sachinthaLUT/RIGOR/photos/README.md

# Photos

Photographs of the built rig (CC BY 4.0). Resized to 2000 px; camera metadata removed.

| File | Shows |
|---|---|
| [`rig_overview.jpg`](rig_overview.jpg) | Complete rig: control enclosure, actuator, load cell and reaction plate on the T-slot frame |
| [`enclosure.jpg`](enclosure.jpg) | Control enclosure with touchscreen, emergency stop and cable glands |
| [`enclosure_lid.jpg`](enclosure_lid.jpg) | Enclosure lid, outside |
| [`enclosure_lid_inside.jpg`](enclosure_lid_inside.jpg) | Enclosure lid, inside: touchscreen module and e-stop wiring |
| [`enclosure_open.jpg`](enclosure_open.jpg) | Enclosure body with the controller PCB fitted |
| [`pcb_v2.1.jpg`](pcb_v2.1.jpg) | Controller PCB V2.1, populated (silkscreen "V2.1 240926") |
