sachinthaLUT/RIGOR/hardware/electronics/datasheets/README.md

# Datasheets

Vendor documents for the main parts, included for convenience. They belong to
their manufacturers and are **not** covered by this repository's licences.
The official sources are linked so you can check for newer versions.

| File | Part | Official source |
|---|---|---|
| `Load cell datasheet.pdf` | ATO-LCC-DYMH-103 load cell | https://www.ato.com/tension-and-compression-load-cell-1kg-to-200kg |
| `OK648 actuator.pdf` | VEVOR OK648 linear actuator | https://eur.vevor.com/linear-actuator-c_44437/vevor-linear-actuator-12v-4-inch-high-load-330lbs-1500n-0-19-s-ip54-protection-p_010907137841 |
| `Motor Driver.pdf` | Pololu G2 High-Power Motor Driver 18v25 (#2994) | https://www.pololu.com/product/2994 |
| `Olimex ADS1220 Breakout Schematic.pdf` | Olimex BB-ADS1220 | https://www.olimex.com/Products/Breadboarding/BB-ADS1220/ |
| `Power supply.pdf` | Mean Well GST160A12-R7B | https://www.meanwell.com/ |
| `Power connector.pdf` | Kycon KPJX-PM-4S panel jack | https://www.kycon.com/ |
| `5.0inch_ESP32-8048S050/` | Sunton ESP32-8048S050 touchscreen: specification, schematics, dimensions, user manual, ESP32-S3 datasheets | https://wiki.makerfabs.com/Sunton_ESP32_S3_5_7_inch_IPS_with_Touch.html |

Other key parts:

| Part | Official source |
|---|---|
| TI ADS1220 (ADC on the Olimex board) | https://www.ti.com/product/ADS1220 |
| Allegro ACS773 current sensor | https://www.allegromicro.com/en/products/sense/current-sensor-ics/fifty-to-two-hundred-amp-integrated-conductor-sensor-ics/acs773 |
| Arduino Nano ESP32 | https://docs.arduino.cc/hardware/nano-esp32/ |
| IDEC AB6E-3BV02PRM emergency stop | https://www.idec.com/ |
