sachinthaLUT/RIGOR/hardware/electronics/gerbers/README.md

# Gerbers

| File | Revision | Status |
|---|---|---|
| `RIGOR_PCB_V2.1_gerbers.zip` | V2.1 (silkscreen `V2.1 240926`, generated 24 Sep 2026) | **Built and characterised in the paper.** Order this to reproduce the published rig. |
| `RIGOR_PCB_V2.2_gerbers.zip` | V2.2 (silkscreen `V2.2 151026`, generated 6 Nov 2026) | Matches the current KiCad project. Touchscreen UART connector J2 re-pinned. Not yet fabricated or tested. |

Both are two-layer boards exported from KiCad 10 (copper, mask, paste,
silkscreen, edge cuts, plated and non-plated drill). Upload the zip as-is to
the PCB fab; the boards were made by JLCPCB with default settings.
