sachinthaLUT/RIGOR/hardware/electronics/kicad/Force_Rig_PCB_V2/PCB Current calculations.xlsx

 | Amps | Volts | Power (W)
Power supply | 11.5 | 12 | 138
 | Rated Amps | Volts | Max Current (Estimated)
Actuator | 5 | 12 | 20
Vevor OK648-1500N
 | Trace width (mils) | Cu Oz
PCB | 486.6206678 | 1
 | K (outer layer) | Delta T | Thickness (mils)
1 Oz Cu | 0.048 | 20 | 1.37
 |  | Max temp diff allowed in C
1 mil = 39.3701mm
Trace width (mm) | 12.36015829 | 13mm
 | Trace width (mils) | Cu Oz
PCB | 243.3103339 | 1
 | K (outer layer) | Delta T | Thickness (mils)
2 Oz Cu | 0.048 | 20 | 2.74
 |  | Max temp diff allowed in C
1 mil = 39.3701mm
Trace width (mm) | 6.180079143 | 7mm
