sachinthaLUT/RIGOR/firmware/hmi/TouchScreenESP32Firmware/mockups/02_Home.png

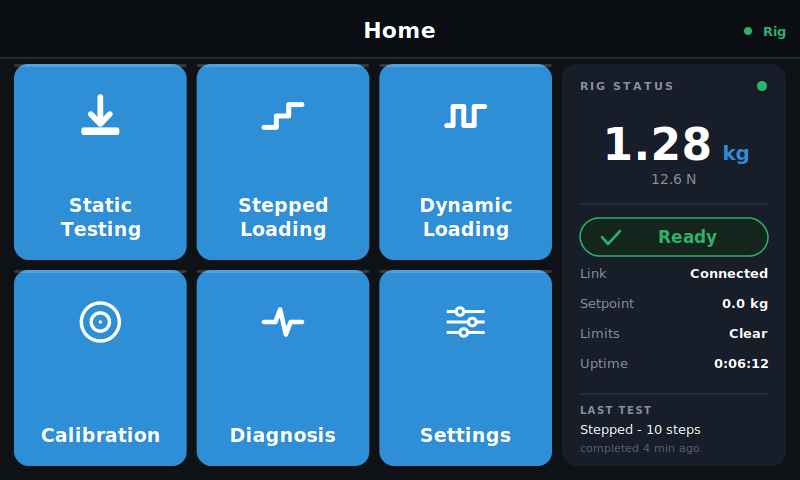
firmware/hmi/TouchScreenESP32Firmware/mockups/02_Home.png
