sachinthaLUT/RIGOR/firmware/hmi/TouchScreenESP32Firmware/mockups/03b_Static_Custom_Keypad.png

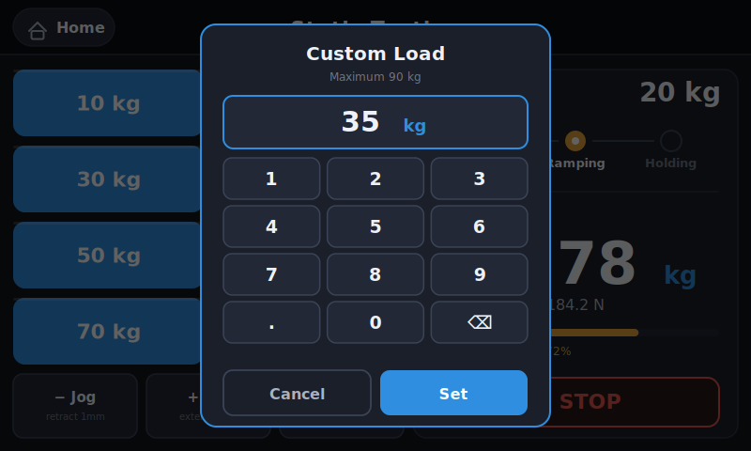
firmware/hmi/TouchScreenESP32Firmware/mockups/03b_Static_Custom_Keypad.png
