sachinthaLUT/RIGOR/firmware/hmi/TouchScreenESP32Firmware/mockups/04_Stepped_Loading.png

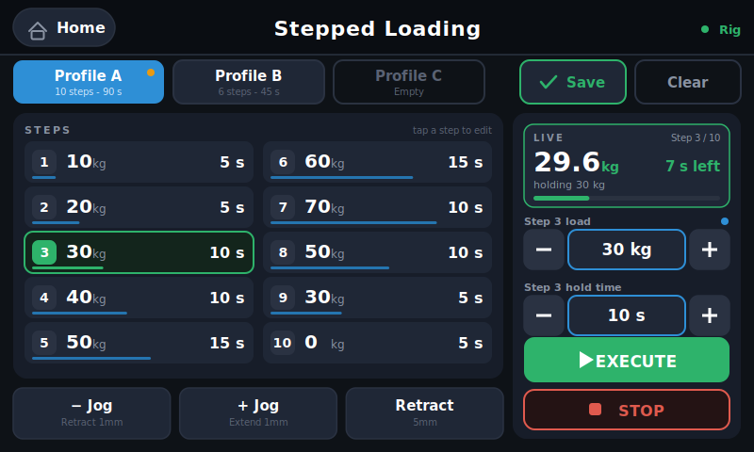
firmware/hmi/TouchScreenESP32Firmware/mockups/04_Stepped_Loading.png
