sachinthaLUT/RIGOR/firmware/hmi/TouchScreenESP32Firmware/mockups/05_Dynamic_Loading.png

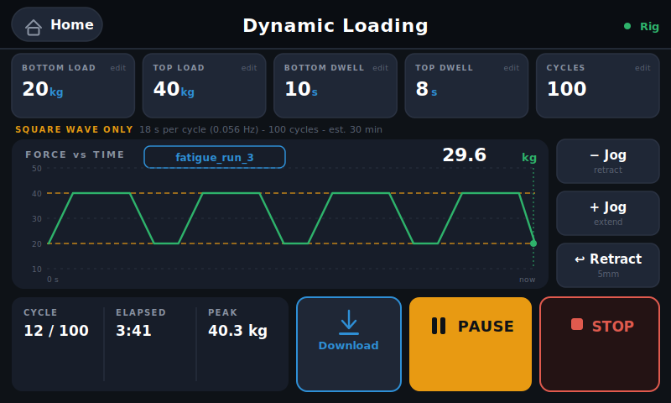
firmware/hmi/TouchScreenESP32Firmware/mockups/05_Dynamic_Loading.png
