sachinthaLUT/RIGOR/firmware/hmi/TouchScreenESP32Firmware/mockups/05b_Dynamic_Download.png

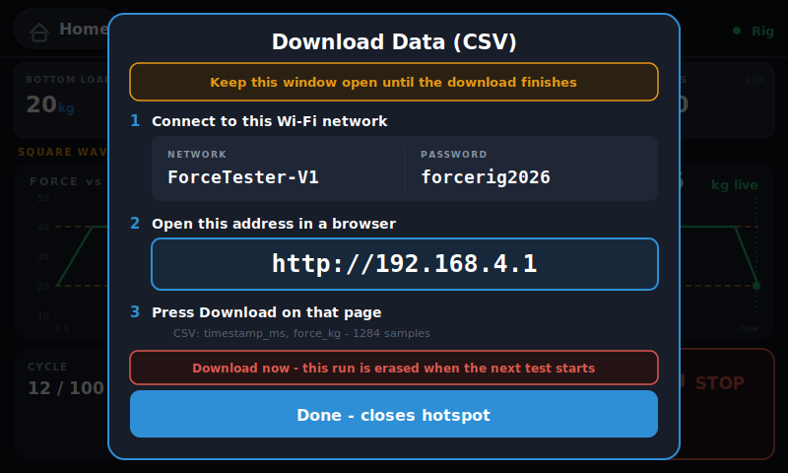
firmware/hmi/TouchScreenESP32Firmware/mockups/05b_Dynamic_Download.png
