sachinthaLUT/RIGOR/firmware/hmi/TouchScreenESP32Firmware/mockups/06_Diagnosis.png

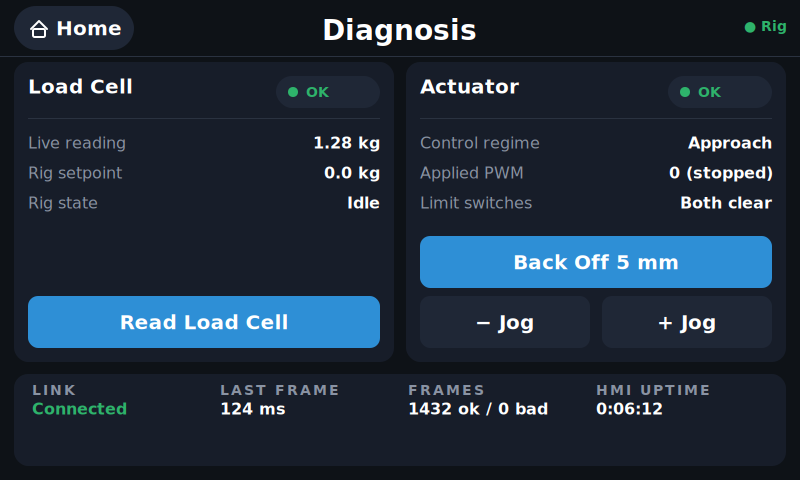
firmware/hmi/TouchScreenESP32Firmware/mockups/06_Diagnosis.png
