sachinthaLUT/RIGOR/firmware/hmi/TouchScreenESP32Firmware/mockups/06_WebPage.png

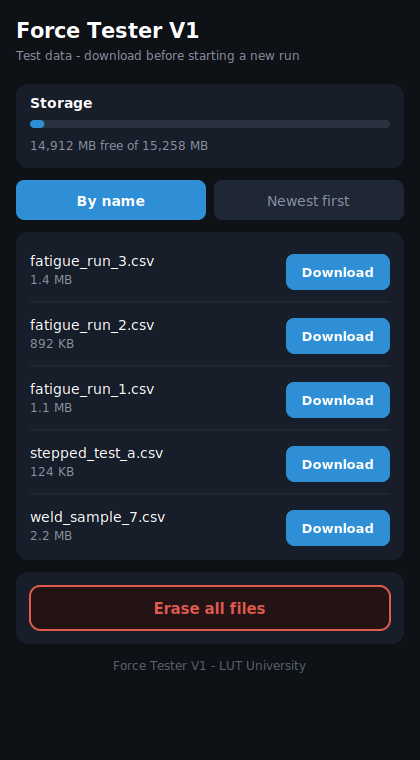
firmware/hmi/TouchScreenESP32Firmware/mockups/06_WebPage.png
