sachinthaLUT/RIGOR/firmware/hmi/TouchScreenESP32Firmware/mockups/07_Settings.png

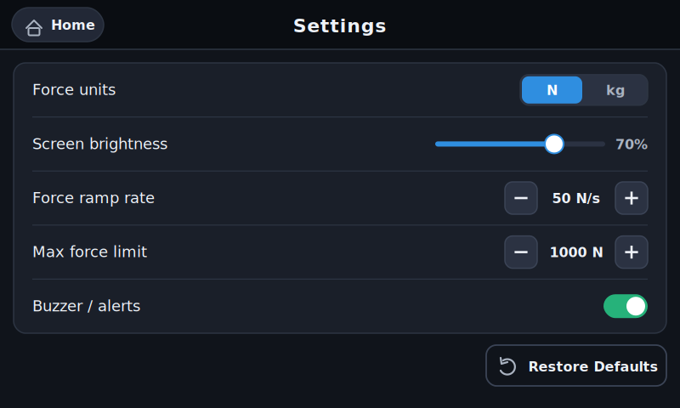
firmware/hmi/TouchScreenESP32Firmware/mockups/07_Settings.png
