sachinthaLUT/RIGOR/firmware/hmi/TouchScreenESP32Firmware/mockups/08_About.png

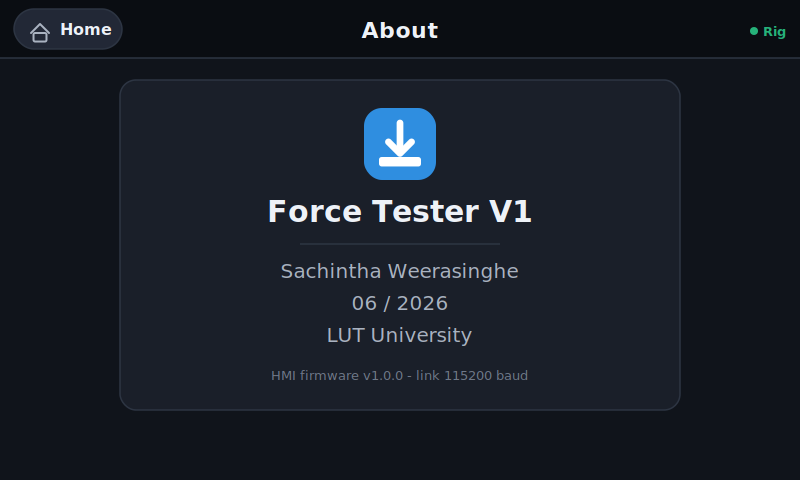
firmware/hmi/TouchScreenESP32Firmware/mockups/08_About.png
