sachinthaLUT/RIGOR/hardware/electronics/kicad/Force_Rig_PCB_V2/Back image.png

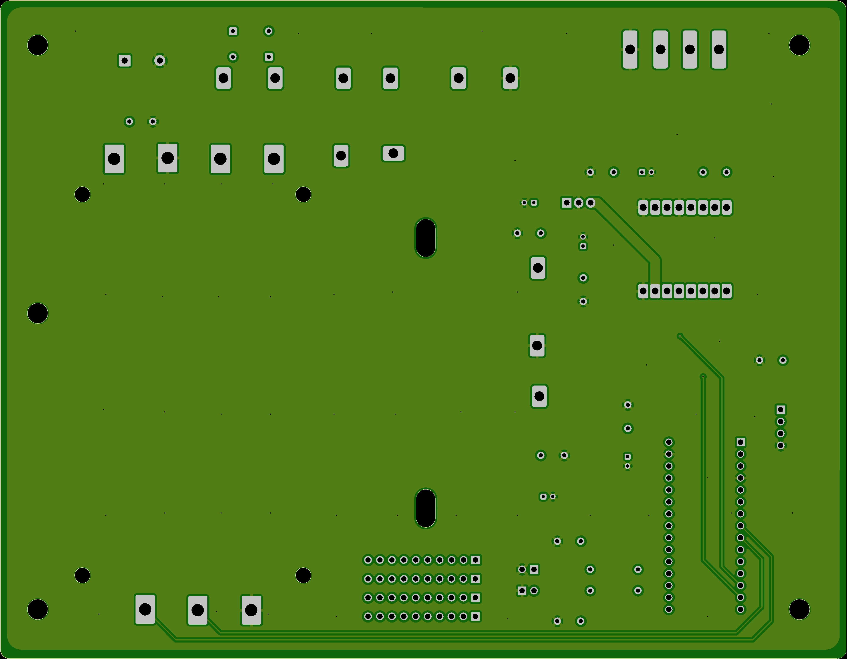
hardware/electronics/kicad/Force_Rig_PCB_V2/Back image.png
