sachinthaLUT/RIGOR/hardware/electronics/kicad/Force_Rig_PCB_V2/Front image.png

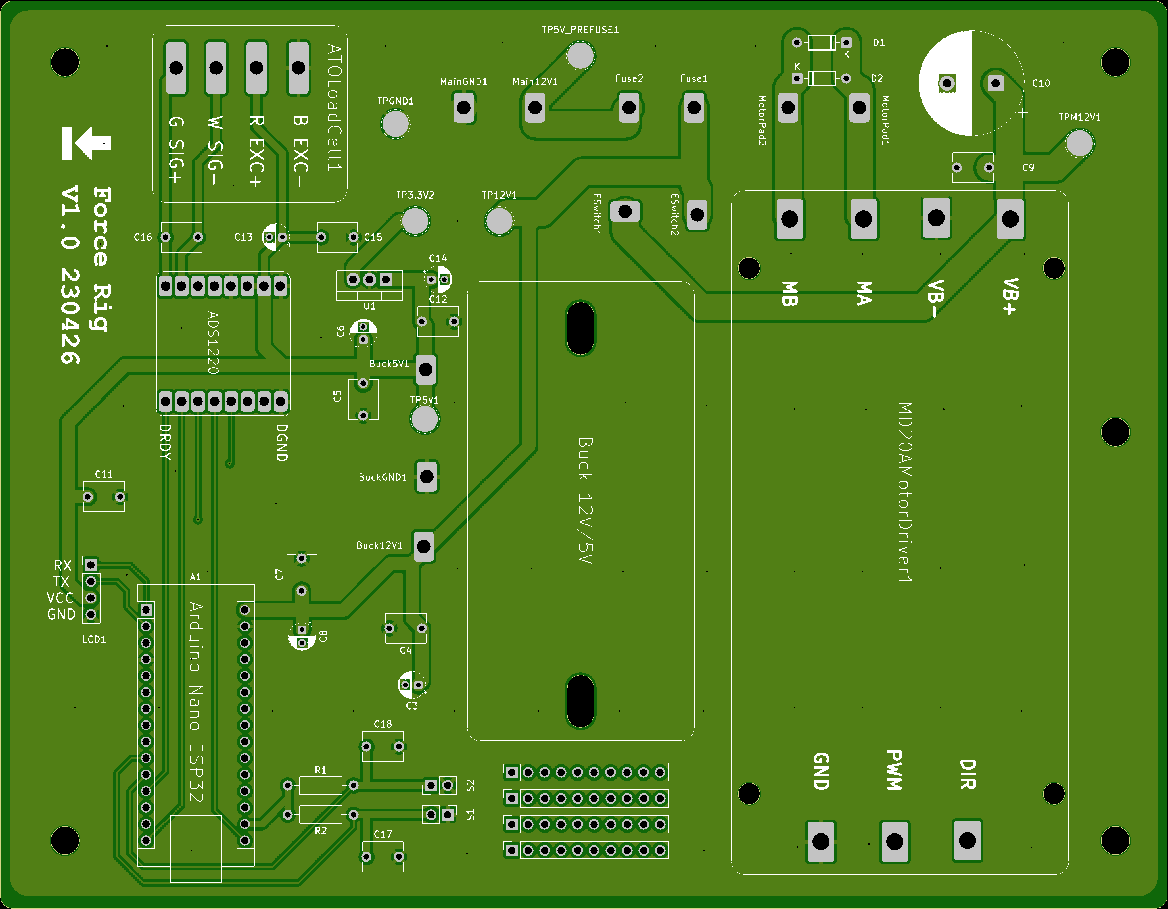
hardware/electronics/kicad/Force_Rig_PCB_V2/Front image.png
