sachinthaLUT/RIGOR/hardware/electronics/kicad/Force_Rig_PCB_V2/Graphics/PCB Isometric.png

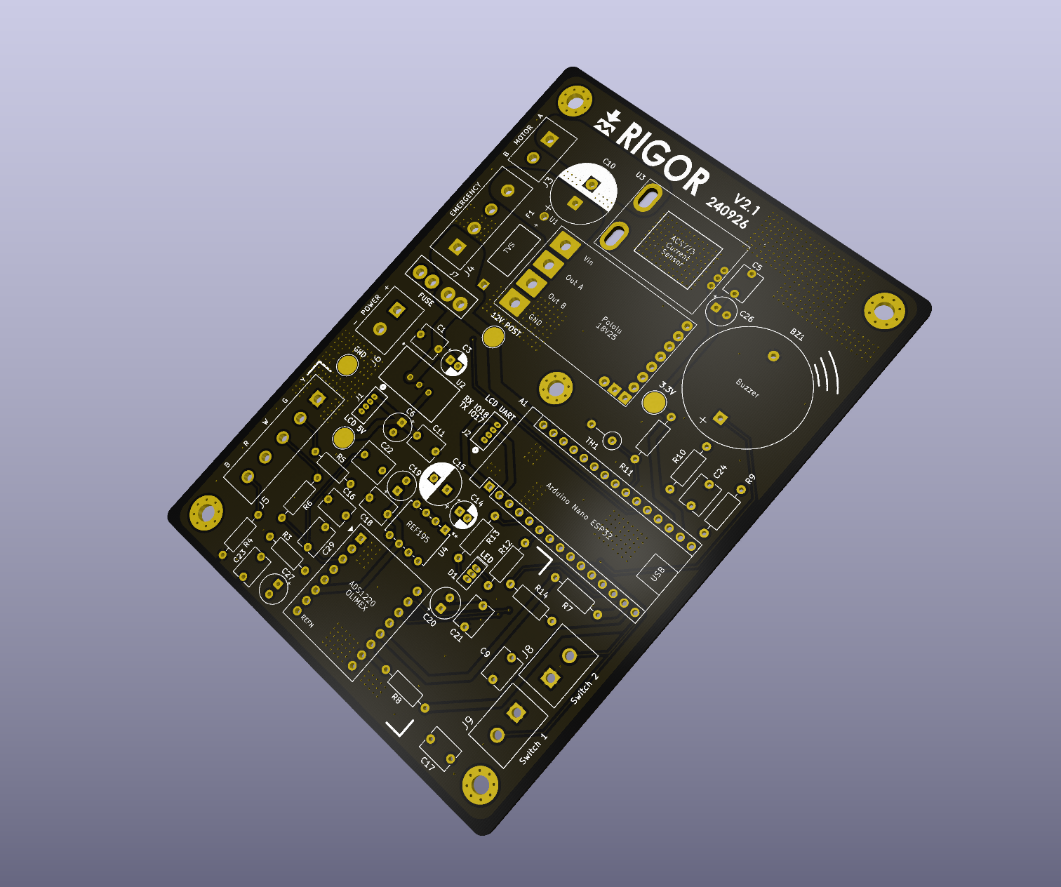
hardware/electronics/kicad/Force_Rig_PCB_V2/Graphics/PCB Isometric.png
