sachinthaLUT/RIGOR/photos/enclosure_lid.jpg

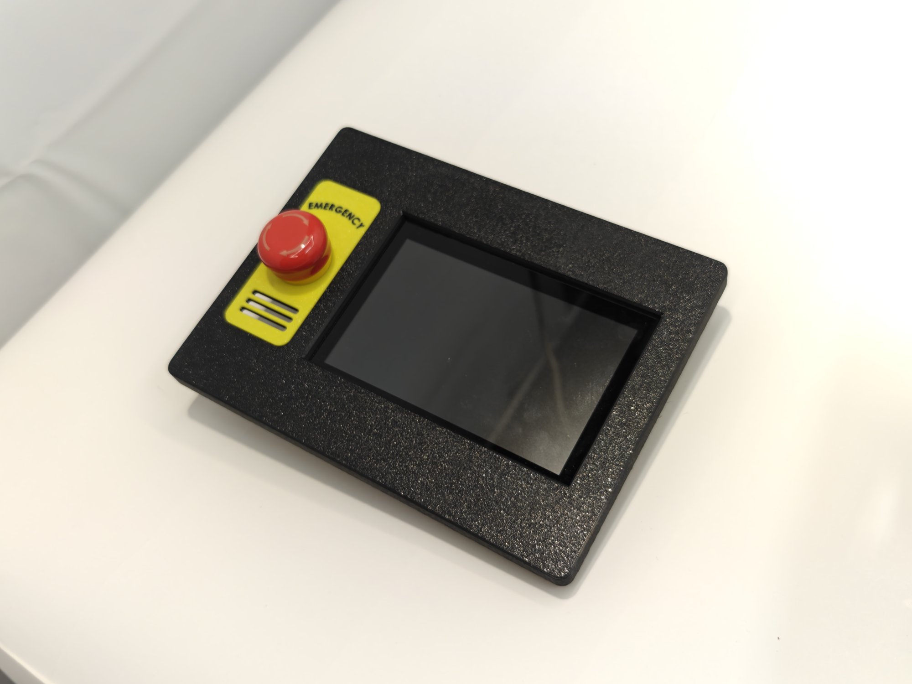
photos/enclosure_lid.jpg
