sachinthaLUT/RIGOR/photos/enclosure_lid_inside.jpg

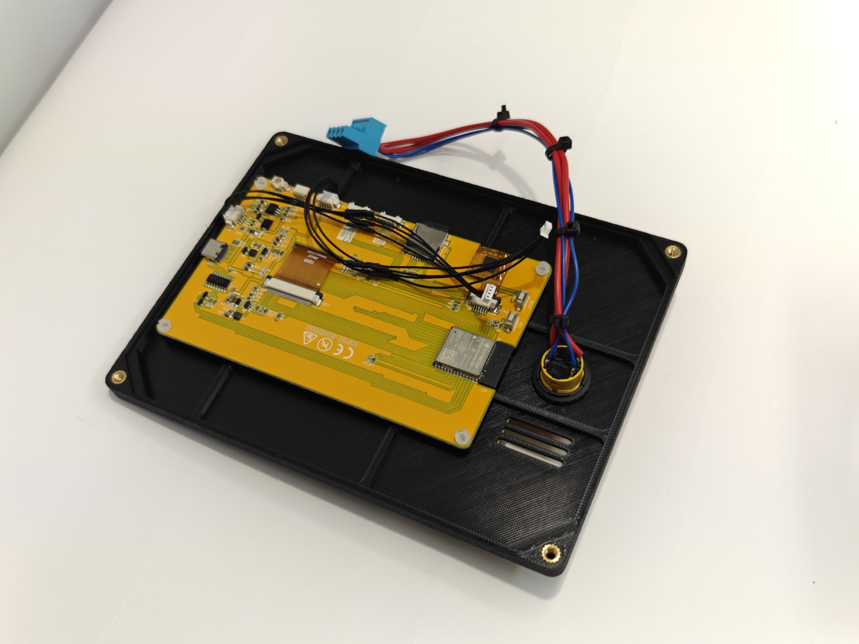
photos/enclosure_lid_inside.jpg
