sachinthaLUT/RIGOR/hardware/bom/BOM.csv

Item | Section | Table 3 category | Component | Function / where used | Manufacturer | Manufacturer part no. / specification | Supplier | Supplier part no. | Qty | Unit price (€) | Line total (€) | Product URL | Datasheet URL | Notes | Price source
A. Actuation and sensing
A1 | A | Linear actuator | Linear actuator | Prime mover; self-locking leadscrew, built-in limit switches | VEVOR | 12 V, 4 in (100 mm) stroke, 1500 N (330 lb), 0.19 in/s (≈5 mm/s), IP54 | VEVOR EU | 010907137841 | 1 | 30 | 30 | https://eur.vevor.com/linear-actuator-c_44437/vevor-linear-actuator-12v-4-inch-high-load-330lbs-1500n-0-19-s-ip54-protection-p_010907137841 |  | 25 % duty cycle | User (as purchased)
A2 | A | Load cell | Load cell, 100 kg | In-line force measurement, tension/compression, M6 both ends | ATO | ATO-LCC-DYMH-103 | ATO | ATO-LCC-DYMH-103 (100 kg) | 1 | 125 | 125 | https://www.ato.com/tension-and-compression-load-cell-1kg-to-200kg |  | Product page covers 1–200 kg; order the 100 kg variant | User (as purchased)
B. Controller PCB V2.1: board, modules and ICs
B1 | B | Controller PCB V2.1 | Bare PCB V2.1 | Controller board (KiCad files in repository) | JLCPCB | RIGOR controller PCB V2.1 | JLCPCB | — | 1 | 40 | 40 | https://jlcpcb.com |  | Cost of the minimum-order batch, excluding shipping; spare boards included | User (JLCPCB order)
B2 | B | Controller PCB V2.1 | Microcontroller, Arduino Nano ESP32 | 50 Hz force loop, safety supervision, UART to touchscreen | Arduino | ABX00083 | Digi-Key | 1050-ABX00083-ND | 1 | 17.13 | 17.13 | https://www.digikey.fi/en/products/result?keywords=1050-ABX00083-ND | https://mm.digikey.com/Volume0/opasdata/d220001/medias/docus/9031/ABX00083.pdf |  | Digi-Key order (user export)
B3 | B | Controller PCB V2.1 | ADC breakout, Olimex BB-ADS1220 | 24-bit ΔΣ load-cell ADC, PGA ×128, ratiometric | Olimex LTD | BB-ADS1220 | Digi-Key | 1188-BB-ADS1220-ND | 1 | 16.29 | 16.29 | https://www.digikey.fi/en/products/result?keywords=1188-BB-ADS1220-ND | https://www.olimex.com/Products/Breadboarding/BB-ADS1220/resources/ads1220.pdf |  | Digi-Key order (user export)
B4 | B | Motor driver | Motor driver, Pololu G2 High-Power 18v25 | Actuator H-bridge, PWM + DIR at 20 kHz, fault output | Pololu | 2994 | Digi-Key | 2183-2994-ND | 1 | 50.55 | 50.55 | https://www.digikey.fi/en/products/result?keywords=2183-2994-ND | https://www.pololu.com/product-info-merged/2994 |  | Digi-Key order (user export)
B5 | B | Controller PCB V2.1 | Current sensor ACS773 (±50 A) | Hall-effect motor-current sensing, in series with the motor | Allegro MicroSystems | ACS773LCB-050B-PFF-T | Digi-Key | ACS773LCB-050B-PFF-T-ND | 1 | 8.94 | 8.94 | https://www.digikey.fi/en/products/result?keywords=ACS773LCB-050B-PFF-T-ND | https://www.allegromicro.com/~/media/Files/Datasheets/ACS773-Datasheet.ashx |  | Digi-Key order (user export)
B6 | B | Controller PCB V2.1 | DC-DC converter 5 V, 10 W (Traco TSR 2-2450) | 12 V → 5 V logic supply | Traco Power | TSR 2-2450 | Digi-Key | 1951-2692-ND | 1 | 11.75 | 11.75 | https://www.digikey.fi/en/products/result?keywords=1951-2692-ND | https://www.tracopower.com/products/tsr2.pdf |  | Digi-Key order (user export)
B7 | B | Controller PCB V2.1 | Voltage reference 5 V (REF195) | Precision 5 V reference | Analog Devices Inc. | REF195GPZ | Digi-Key | REF195GPZ-ND | 1 | 7.72 | 7.72 | https://www.digikey.fi/en/products/result?keywords=REF195GPZ-ND | https://www.analog.com/media/en/technical-documentation/data-sheets/REF19XSERIES.pdf |  | Digi-Key order (user export)
B8 | B | Controller PCB V2.1 | NTC thermistor 10 kΩ, B 3950 | Motor-driver temperature (over-temperature protection) | Vishay Ametherm | PANE103395 | Digi-Key | 570-PANE103395-ND | 1 | 2.35 | 2.35 | https://www.digikey.fi/en/products/result?keywords=570-PANE103395-ND | https://www.ametherm.com/datasheetspdf/PANE103395.pdf | Bonded to the driver with thermal epoxy (section G) | Digi-Key order (user export)
B9 | B | Controller PCB V2.1 | Piezo buzzer 23 mm | Audible alarms and confirmations | Mallory Sonalert Products Inc. | MSR205NSR | Digi-Key | 458-1314-ND | 1 | 11.02 | 11.02 | https://www.digikey.fi/en/products/result?keywords=458-1314-ND | https://www.mspindy.com/spec-sheets/MSR205NSR.pdf |  | Digi-Key order (user export)
B10 | B | Controller PCB V2.1 | Bi-colour LED, red/green | Status indicator | Broadcom Limited | HLMP-0800 | Digi-Key | 516-1280-ND | 1 | 1 | 1 | https://www.digikey.fi/en/products/result?keywords=516-1280-ND | https://docs.broadcom.com/docs/AV02-1552EN |  | Digi-Key order (user export)
B11 | B | Controller PCB V2.1 | Fuse holder, blade, PCB mount | Motor-supply fuse holder | Keystone Electronics | 3544-2 | Digi-Key | 36-3544-2-ND | 1 | 0.87 | 0.87 | https://www.digikey.fi/en/products/result?keywords=36-3544-2-ND | https://www.keyelco.com/userAssets/file/K75p48.pdf |  | Digi-Key order (user export)
B12 | B | Controller PCB V2.1 | Fuse 20 A, mini blade | Motor-supply overcurrent protection | Littelfuse Inc. | 0297020.WXNV | Digi-Key | F993-ND | 1 | 0.35 | 0.35 | https://www.digikey.fi/en/products/result?keywords=F993-ND | https://www.littelfuse.com/assetdocs/littelfuse_datasheet_297_mini32v.pdf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 |  | Digi-Key order (user export)
B13 | B | Controller PCB V2.1 | TVS diode 1.5KE20CA (bidirectional) | Transient suppression on the 12 V motor supply | Littelfuse Inc. | 1.5KE20CA | Digi-Key | 1.5KE20CALFCT-ND | 1 | 1.01 | 1.01 | https://www.digikey.fi/en/products/result?keywords=1.5KE20CALFCT-ND | https://www.littelfuse.com/media?itemid=9D02C7D2-86A5-4BFF-9251-966D6AF02BF7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 |  | Digi-Key order (user export)
C. Controller PCB V2.1: passives and connectors
C1 | C | Controller PCB V2.1 | Capacitor 100 nF, 100 V, X7R | Decoupling | Vishay Beyschlag/Draloric/BC Components | K104K15X7RH53H5G | Digi-Key | 56-K104K15X7RH53H5G-ND | 6 | 0.83 | 4.98 | https://www.digikey.fi/en/products/result?keywords=56-K104K15X7RH53H5G-ND | https://www.vishay.com/docs/45250/kgseries.pdf |  | Digi-Key order (user export)
C2 | C | Controller PCB V2.1 | Capacitor 100 nF, 50 V, ceramic (Murata) | Decoupling / filtering | Murata Electronics | RDE5C1H104J2K1H03B | Digi-Key | 490-RDE5C1H104J2K1H03B-ND | 5 | 0.75 | 3.75 | https://www.digikey.fi/en/products/result?keywords=490-RDE5C1H104J2K1H03B-ND | https://pim.murata.com/asset/pim4/ceramicCapacitorLead/RDE_C0G_50V-100V_E_PDF_CERAMICCAPACITORLEAD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 |  | Digi-Key order (user export)
C3 | C | Controller PCB V2.1 | Capacitor 1 µF, 63 V, film | Filtering | KEMET | R82DC4100DQ60J | Digi-Key | 399-5447-1-ND | 1 | 0.59 | 0.59 | https://www.digikey.fi/en/products/result?keywords=399-5447-1-ND | https://yageogroup.com/content/datasheet/asset/file/KEM_F3101_R82 |  | Digi-Key order (user export)
C4 | C | Controller PCB V2.1 | Capacitor 10 µF, 20 V, tantalum | Supply decoupling | KYOCERA AVX | TAP106J020SRN | Digi-Key | 478-TAP106J020SRNCT-ND | 5 | 1.54 | 7.7 | https://www.digikey.fi/en/products/result?keywords=478-TAP106J020SRNCT-ND | http://datasheets.avx.com/tap.pdf |  | Digi-Key order (user export)
C5 | C | Controller PCB V2.1 | Capacitor 10 µF, 50 V, electrolytic | Supply decoupling | Würth Elektronik | 860020672010 | Digi-Key | 732-8856-1-ND | 3 | 0.1 | 0.3 | https://www.digikey.fi/en/products/result?keywords=732-8856-1-ND | https://www.we-online.com/components/products/datasheet/860020672010.pdf |  | Digi-Key order (user export)
C6 | C | Controller PCB V2.1 | Capacitor 100 µF, 50 V, electrolytic | Supply bulk capacitance | Würth Elektronik | 860040674004 | Digi-Key | 732-9187-1-ND | 1 | 0.31 | 0.31 | https://www.digikey.fi/en/products/result?keywords=732-9187-1-ND | https://www.we-online.com/components/products/datasheet/860040674004.pdf |  | Digi-Key order (user export)
C7 | C | Controller PCB V2.1 | Capacitor 1000 µF, 50 V, electrolytic | Motor-supply bulk capacitance | Würth Elektronik | 860010678024 | Digi-Key | 732-8676-1-ND | 1 | 1.27 | 1.27 | https://www.digikey.fi/en/products/result?keywords=732-8676-1-ND | https://www.we-online.com/components/products/datasheet/860010678024.pdf |  | Digi-Key order (user export)
C8 | C | Controller PCB V2.1 | Resistor 10 Ω, 1/4 W |  | YAGEO | CFR-25JT-52-10R | Digi-Key | 13-CFR-25JT-52-10RCT-ND | 3 | 0.09 | 0.27 | https://www.digikey.fi/en/products/result?keywords=13-CFR-25JT-52-10RCT-ND | https://yageogroup.com/content/datasheet/asset/file/YAGEO-CFR_DATASHEET |  | Digi-Key order (user export)
C9 | C | Controller PCB V2.1 | Resistor 33 Ω, 1/4 W |  | Stackpole Electronics Inc | CF14JT33R0 | Digi-Key | CF14JT33R0CT-ND | 4 | 0.09 | 0.36 | https://www.digikey.fi/en/products/result?keywords=CF14JT33R0CT-ND | https://www.seielect.com/catalog/SEI-CF_CFM.pdf |  | Digi-Key order (user export)
C10 | C | Controller PCB V2.1 | Resistor 220 Ω, 1/4 W | LED current limiting | Stackpole Electronics Inc | CF14JT220R | Digi-Key | CF14JT220RCT-ND | 3 | 0.09 | 0.27 | https://www.digikey.fi/en/products/result?keywords=CF14JT220RCT-ND | https://www.seielect.com/catalog/SEI-CF_CFM.pdf |  | Digi-Key order (user export)
C11 | C | Controller PCB V2.1 | Resistor 1 kΩ, 1/4 W | Pull-up / RC filtering | Stackpole Electronics Inc | CF14JT1K00 | Digi-Key | CF14JT1K00CT-ND | 2 | 0.09 | 0.18 | https://www.digikey.fi/en/products/result?keywords=CF14JT1K00CT-ND | https://www.seielect.com/catalog/SEI-CF_CFM.pdf |  | Digi-Key order (user export)
C12 | C | Controller PCB V2.1 | Resistor 10 kΩ, 1/4 W | Thermistor divider / pull-ups | Stackpole Electronics Inc | CF14JT10K0 | Digi-Key | CF14JT10K0CT-ND | 4 | 0.09 | 0.36 | https://www.digikey.fi/en/products/result?keywords=CF14JT10K0CT-ND | https://www.seielect.com/catalog/SEI-CF_CFM.pdf |  | Digi-Key order (user export)
C13 | C | Controller PCB V2.1 | Terminal block header, 2-pos, 5.08 mm | Off-board connections | Same Sky (Formerly CUI Devices) | TBP01R2-508-02BE | Digi-Key | 102-6422-ND | 4 | 0.24 | 0.96 | https://www.digikey.fi/en/products/result?keywords=102-6422-ND | https://www.cuidevices.com/product/resource/tbp01r2-508.pdf |  | Digi-Key order (user export)
C14 | C | Controller PCB V2.1 | Terminal block plug, 2-pos, 5.08 mm | Off-board connections | Same Sky (Formerly CUI Devices) | TBP01P1-508-02BE | Digi-Key | 102-6390-ND | 4 | 0.6 | 2.4 | https://www.digikey.fi/en/products/result?keywords=102-6390-ND | https://www.cuidevices.com/product/resource/tbp01p1-508.pdf |  | Digi-Key order (user export)
C15 | C | Controller PCB V2.1 | Terminal block header, 4-pos, 5.08 mm | Off-board connections | Same Sky (Formerly CUI Devices) | TBP01R2-508-04BE | Digi-Key | 102-6424-ND | 1 | 0.46 | 0.46 | https://www.digikey.fi/en/products/result?keywords=102-6424-ND | https://www.cuidevices.com/product/resource/tbp01r2-508.pdf |  | Digi-Key order (user export)
C16 | C | Controller PCB V2.1 | Terminal block plug, 4-pos, 5.08 mm | Off-board connections | Same Sky (Formerly CUI Devices) | TBP01P1-508-04BE | Digi-Key | 102-6392-ND | 1 | 1.26 | 1.26 | https://www.digikey.fi/en/products/result?keywords=102-6392-ND | https://www.cuidevices.com/product/resource/tbp01p1-508.pdf |  | Digi-Key order (user export)
C17 | C | Controller PCB V2.1 | Terminal block header, 5-pos, 5.08 mm | Off-board connections | Same Sky (Formerly CUI Devices) | TBP01R2-508-05BE | Digi-Key | 102-6425-ND | 1 | 0.6 | 0.6 | https://www.digikey.fi/en/products/result?keywords=102-6425-ND | https://www.cuidevices.com/product/resource/tbp01r2-508.pdf |  | Digi-Key order (user export)
C18 | C | Controller PCB V2.1 | Terminal block plug, 5-pos, 5.08 mm | Off-board connections | Same Sky (Formerly CUI Devices) | TBP01P1-508-05BE | Digi-Key | 102-6393-ND | 1 | 1.63 | 1.63 | https://www.digikey.fi/en/products/result?keywords=102-6393-ND | https://www.cuidevices.com/product/resource/tbp01p1-508.pdf |  | Digi-Key order (user export)
C19 | C | Controller PCB V2.1 | PicoBlade header, 4-pos, 1.25 mm | Wire-to-board connector | Molex | 0530470410 | Digi-Key | WM1733-ND | 2 | 0.24 | 0.48 | https://www.digikey.fi/en/products/result?keywords=WM1733-ND | https://www.molex.com/pdm_docs/sd/530470410_sd.pdf |  | Digi-Key order (user export)
C20 | C | Controller PCB V2.1 | Female header, 15-pos, 2.54 mm | Socket for the Arduino Nano ESP32 | Sullins Connector Solutions | PPTC151LFBN-RC | Digi-Key | S7013-ND | 2 | 0.82 | 1.64 | https://www.digikey.fi/en/products/result?keywords=S7013-ND | https://mm.digikey.com/Volume0/opasdata/d220001/medias/docus/937/Female_Headers.100_DS.pdf |  | Digi-Key order (user export)
C21 | C | Controller PCB V2.1 | Female header, 8-pos, 2.54 mm | Socket for the ADC breakout | Sullins Connector Solutions | PPTC081LFBN-RC | Digi-Key | S7006-ND | 2 | 0.51 | 1.02 | https://www.digikey.fi/en/products/result?keywords=S7006-ND | https://mm.digikey.com/Volume0/opasdata/d220001/medias/docus/937/Female_Headers.100_DS.pdf |  | Digi-Key order (user export)
C22 | C | Controller PCB V2.1 | Solder-mount PCB pin (Mill-Max) | PCB terminal pins | Mill-Max Manufacturing Corp. | 4914-0-00-15-00-00-03-0 | Digi-Key | 54-4914-0-00-15-00-00-03-0-ND | 4 | 0.92 | 3.68 | https://www.digikey.fi/en/products/result?keywords=54-4914-0-00-15-00-00-03-0-ND | https://mm.digikey.com/Volume0/opasdata/d220001/medias/docus/7161/Mill%20Max%20catalog.pdf |  | Digi-Key order (user export)
D. Interface, enclosure and power
D1 | D | Touchscreen interface | Touchscreen, Sunton ESP32-S3 5-inch 800×480 IPS, capacitive | User interface, test sequencing, microSD logging, Wi-Fi download | Sunton | ESP32-8048S050C | Makerfabs | — | 1 | 42 | 42 | https://wiki.makerfabs.com/Sunton_ESP32_S3_5_7_inch_IPS_with_Touch.html |  | Capacitive (GT911) variant of the ESP32-8048S050. Original store listing discontinued; link is the product wiki | User (as purchased)
D2 | D | Enclosure and wiring | Enclosure, 3D-printed | Houses PCB, driver, touchscreen and e-stop | In-house | FDM print (STL in repository) | In-house | — | 1 | 10 | 10 |  |  | Filament cost | User (estimate)
D3 | D | Enclosure and wiring | Emergency stop, latching, IDEC X6 | Removes drive to the actuator; sensed by the controller | IDEC | AB6E-3BV02PRM | Digi-Key | 1885-AB6E-3BV02PRM-ND | 1 | 40.94 | 40.94 | https://www.digikey.fi/en/products/result?keywords=1885-AB6E-3BV02PRM-ND | https://www.apem.com/en-us/medias/download/D007_D012_X6_APEM.pdf | Alternative supplier: RS 282-1472, https://fi.rsdelivers.com/product/idec/ab6e-3bv02prm/idec-x6-series-latching-emergency-stop-push-button/2821472 | Digi-Key order (user export)
D4 | D | Enclosure and wiring | Power supply 12 V, 11.5 A, 138 W (Mean Well GST160A12) | Actuator and logic supply | MEAN WELL USA Inc. | GST160A12-R7B | Digi-Key | 1866-2044-ND | 1 | 48.3 | 48.3 | https://www.digikey.fi/en/products/result?keywords=1866-2044-ND | https://www.meanwellusa.com/upload/pdf/GST160A/GST160A-spec.pdf | Alternative supplier: RS 117-6149, https://fi.rsdelivers.com/product/mean-well/gst160a12-r7b/mean-well-ac/dc-adapter-264v-ac-output-115-a-12-v-dc/1176149 | Digi-Key order (user export)
D5 | D | Enclosure and wiring | Power jack, 4-pin DIN, panel | Mates with the supply’s R7B plug | Kycon, Inc. | KPJX-PM-4S | Digi-Key | 2092-KPJX-PM-4S-ND | 1 | 2.17 | 2.17 | https://www.digikey.fi/en/products/result?keywords=2092-KPJX-PM-4S-ND | https://mm.digikey.com/Volume0/opasdata/d220001/medias/docus/316/KPJX-PM_Panel_Cutout.pdf |  | Digi-Key order (user export)
D6 | D | Enclosure and wiring | Rocker switch, SPST | Main power switch | Adam Tech | SW-R3-1A-A-LG13-2 | Digi-Key | 2057-SW-R3-1A-A-LG13-2-ND | 1 | 0.93 | 0.93 | https://www.digikey.fi/en/products/result?keywords=2057-SW-R3-1A-A-LG13-2-ND | https://app.adam-tech.com/products/download/data_sheet/203476/sw-r3-1a-a-lxxx-2-data-sheet.pdf |  | Digi-Key order (user export)
D7 | D | Enclosure and wiring | PicoBlade cable assembly, 4-circuit, 150 mm | Internal wiring | Molex | 0151340402 | Digi-Key | WM15258-ND | 2 | 4.12 | 8.24 | https://www.digikey.fi/en/products/result?keywords=WM15258-ND | https://www.molex.com/en-us/products/part-detail/151340402?display=pdf |  | Digi-Key order (user export)
D8 | D | Enclosure and wiring | M3 cheese-head bolts (Keystone 25031) | PCB / enclosure mounting | Keystone Electronics | 25031 | Digi-Key | 36-25031-ND | 8 | 3.24 | 25.92 | https://www.digikey.fi/en/products/result?keywords=36-25031-ND | https://www.keyelco.com/userAssets/file/K75p139.pdf |  | Digi-Key order (user export)
E. Frame and fixtures (made in-house from stock material; not costed)
E1 | E | Frame and fixtures | Base rail, T-slot aluminium profile | Frame carrying actuator and reaction post | TBC | Profile size TBC, length TBC mm | Stock |  | 1
E2 | E | Frame and fixtures | Reaction post, T-slot aluminium profile | Carries the reaction plate | TBC | Profile size TBC, length TBC mm | Stock |  | 1
E3 | E | Frame and fixtures | Reaction-post gussets | Square the post to the rail | TBC | Angle bracket to suit profile | Stock |  | 2
E4 | E | Frame and fixtures | Actuator rear bracket | Clevis mount for the actuator rear eye | In-house (CNC) | Drawing: Actuator bracket 1; material TBC | In-house |  | 1
E5 | E | Frame and fixtures | Actuator front support | Keeps the rod co-axial with the load cell | In-house (CNC) | Drawings: Actuator bracket 2 + BracketLid; material TBC | In-house |  | 1
E6 | E | Frame and fixtures | Rod-to-load-cell adaptor | Joins actuator rod to load cell | In-house | M6 thread; drawing: LoadCellActuatorBracket; material TBC | In-house |  | 1
E7 | E | Frame and fixtures | Loading tup | Contact face in the load line | In-house (turned) | M6 male; drawing: LoadCellPusher; material TBC | In-house |  | 1
E8 | E | Frame and fixtures | Reaction plate | Specimen seats against this face | In-house (CNC) | Drawing: Force plate; material TBC | In-house |  | 1
F. Fasteners, cabling and small items from stock (specification only; not costed)
F1 | F | Frame and fixtures | T-slot nuts, M6 | Fix brackets and post to the profile | — | To suit profile slot | Stock |  | as req.
F2 | F | Frame and fixtures | Socket head cap screws, M6 | Frame, brackets, fixtures | — | ISO 4762, steel 8.8, lengths as req. | Stock |  | as req.
F3 | F | Frame and fixtures | Hex jam nuts, M6 | Lock the load-cell threads | — | ISO 4035, steel | Stock |  | 2
F4 | F | Enclosure and wiring | Screws, M3 | Touchscreen and PCB mounting in enclosure | — | ISO 4762 / ISO 7380, lengths as req. | Stock |  | as req.
F5 | F | Enclosure and wiring | Cable glands | Cable entries on the enclosure | — | Size TBC (e.g. PG7 / M12) | Stock |  | 3
F6 | F | Enclosure and wiring | Load-cell cable extension, 4-core shielded | Load cell to PCB | — | 4 × 0.25 mm², shielded | Stock |  | as req.
F7 | F | Enclosure and wiring | Motor / limit cable and hook-up wire | Actuator to PCB; internal wiring | — | Motor leads ≥ 1 mm² | Stock |  | as req.
F8 | F | Touchscreen interface | microSD card | Test-data logging | — | FAT32, ≤ 32 GB | Stock |  | 1
G. Tools and consumables (not included in the rig total)
G1 | G | Tools and consumables | PicoBlade extraction tool | Crimp-terminal removal | Molex | 0690081070 | Digi-Key | WM9991-ND | 1 | 20.59 | 20.59 | https://www.digikey.fi/en/products/result?keywords=WM9991-ND | https://www.molex.com/en-us/products/part-detail/690081070?display=pdf |  | Digi-Key order (user export)
G2 | G | Tools and consumables | Solder wire 63/37, rosin core | PCB assembly | Chip Quik Inc. | RASW.020 4OZ | Digi-Key | RASW.0204OZ-ND | 1 | 11.65 | 11.65 | https://www.digikey.fi/en/products/result?keywords=RASW.0204OZ-ND | http://www.chipquik.com/datasheets/RASW.020 4OZ.pdf |  | Digi-Key order (user export)
G3 | G | Tools and consumables | Thermally conductive epoxy | Bonding the thermistor to the driver | MG Chemicals | 9460TC-3ML | Digi-Key | 473-9460TC-3ML-ND | 1 | 17.42 | 17.42 | https://www.digikey.fi/en/products/result?keywords=473-9460TC-3ML-ND | https://www.mgchemicals.com/downloads/tds/tds-9460TC.pdf |  | Digi-Key order (user export)
 |  |  | TOTAL, one rig (EUR, excl. 25.5 % VAT and shipping) |  |  |  |  |  |  |  | 536.95
