sachinthaLUT/RIGOR/calibration/Force_Rig_Calibration_Workbook.xlsx

Sheet: README
FORCE RIG — CALIBRATION AND CHARACTERISATION WORKBOOK V1
 | WHAT THIS IS
 | The data and analysis companion to Force_Rig_Calibration_Harness_V1.ino. Every sheet named Tn_... is filled by harness menu item n. T13_Uncertainty and Summary calculate themselves.
 | The load cell itself is calibrated separately on a UTM, in Load_Cell_Calibration_Data_V1.xlsx. Its results enter this workbook in ONE place only: the orange cells on LC_Reference.
 | HOW TO GET DATA IN
 | 1. Run the test from the harness menu (Arduino serial monitor, 115200 baud, Newline, timestamps OFF).
 | 2. At the end the harness asks you to CLEAR the monitor and press ENTER. It then prints only the result rows, tab-separated.
 | 3. Press the monitor's copy button. Click the green cell the harness names (row 2 of every sheet repeats it) and paste. Each value lands in its own cell; no Text-to-Columns step.
 | 4. Sheets marked 'first empty row' take several runs: paste each run directly below the last.
 | 5. Missed it? Type R at the harness menu to print the last block again.
 | COLOUR KEY
 | GREEN | Paste from the serial monitor.
 | ORANGE (thick border) | Carry forward from the load-cell workbook (Paste Special > Values).
 | YELLOW, blue text | Type by hand.
 | GREY | Helper columns. Read by the summaries; do not type in them.
 | white / black | Calculated. Do not overwrite.
 | SHEETS AND MENU NUMBERS
 | Sheet | Harness menu | Purpose
 | Setup | 0 | Session conditions; harness test 0 records what is flashed. Fill in first.
 | LC_Reference | - | Load-cell constants and per-level UTM data, carried forward. Computes ISO q, b, v, f0.
 | T1_Noise_Resolution | 1 | Resolution and noise floor, motor power on/off, free/seated.
 | T2_Command_Accuracy | 2 | Commanded versus achieved force.
 | T3_Repeatability | 3 | Short-term repeatability, nothing disturbed.
 | T4_Seating_GageRR | 4 | Seating reproducibility and crossed Gauge R&R.
 | T5_Direction | 5 | Direction dependence (backlash + deadband).
 | T6_Warmup_Drift | 6 | Warm-up and zero drift from cold, unloaded.
 | T7_Creep_LoopOn | 7 | Creep under sustained load, control loop on.
 | T8_Creep_LoopOff | 8 | Creep with the loop stopped: mechanical relaxation.
 | T9_Step_Response | 9 | Step response: rise, overshoot, settling.
 | T10_Cyclic | 10 | Cyclic amplitude fidelity, practical frequency envelope.
 | T11_Current_vs_Force | 11 | Motor current against force: sets the overcurrent limits from data.
 | T12_Safety | 12 | Protective function verification.
 | T13_Uncertainty | - | Uncertainty budgets (calculated).
 | Summary | - | One page for the paper (calculated).
 | RECOMMENDED ORDER (also menu O on the harness)
 | Before: UTM load-cell calibration with THIS PCB -> Load_Cell_Calibration_Data_V1.xlsx.
 | Before: carry its results into LC_Reference; flash the constants into the harness AND the rig firmware.
 | Before: rig unpowered for 2 h or more (cold). Fill in Setup rows 11-26.
 | 1. Test 0 — session record, right after power-on.
 | 2. Test 6 — warm-up and zero drift, 60 min unloaded. Everything else runs after the warm-up period.
 | 3. Test 1 — resolution and noise. Its declared resolution is used by T6 and T13.
 | 4. P — preload three times (ISO 7500-1 Cl. 6.4.3).
 | 5. Test 2, 6. Test 3, 7. Test 5, 8. Test 4 (one run per operator).
 | 9. Test 9, 10. Test 10 (one run per half-period), 11. Test 11 (2-3 PWM levels).
 | 12. Test 7 and 13. Test 8 (35 min each).
 | 14. Test 12 LAST — it trips protective functions on purpose.
 | After: ambient temperature at end on Setup. T13 and Summary complete themselves.
 | NOTES
 | Force in kg throughout means kilogram-force (N / 9.80665), as in the load-cell workbook. Local gravity does not enter: the reference is a UTM measuring newtons, not dead masses.
 | %FS figures use the working-range upper limit F_N on Setup!B22.
 | ISO 7500-1 Table 2 class limits are copyright and are not reproduced: type them on Setup C30:C34. Until then every verdict reads 'limit not set'.
 | No cell uses an array formula. MAXIFS/MINIFS need Excel 2019 / Microsoft 365 or LibreOffice 5.2+.
 | The harness and the rig firmware use the same control law, limits and protective functions (rig rev 5).

Sheet: Setup
SETUP — session conditions and what is flashed
Harness menu 0 -> paste at B36 (one column, 17 rows)
HOW TO USE: fill the yellow cells before the session. Run harness test 0 right after power-on, while the rig
is still cold, and paste its block at B36. The checks in column C compare it with LC_Reference.
Several sheets read F_N (B22) and the deadband (B23): set them first.
KEY: GREEN = paste from the serial monitor | ORANGE = carry forward from the load-cell workbook | YELLOW, blue text = type by hand | GREY = helper, do not type | white = calculated
SESSION | Value | Unit / note
Date | 16:10:27
Session identifier | 1
Operator(s) | Sachintha Weerasinghe | IDs used in T4
Ambient temperature at start | 22.7 | deg C
Ambient temperature at end | 23.0 | deg C
Relative humidity | 49.9 | %
Temperature span over the session | 0.3 | deg C, calculated; feeds T13 u_T
Warm-up period declared on T6 | 28.3 | minutes, from T6
Load cell rated capacity | 100 | kg
Working range upper limit F_N | 90.0 | kg — every %FS figure uses this | 65 kg = the measured ceiling of the rig. Change it if you claim a different range.
Controller deadband | 0.40 | kg, +/- (DEADBAND_KG)
Reference standard (UTM) identity and certificate
UTM force relative uncertainty, k = 2 |  | fraction, e.g. 0.005 = 0.5 % (from the UTM certificate) | Feeds T13 u_std.
Target ISO 7500-1 class | 1 | 0.5 / 1 / 2 / 3
Calibration plate mass (on the load cell in the UTM only, NOT in the rig) | 0.2214 | kg - added to the fitted intercept for the rig (LC_Reference!B28)
CLASS LIMITS — copy from Table 2 of your licensed ISO 7500-1
Quantity | Symbol | Limit (%)
Relative indication error | q | 1.00 | The standard is copyright; the limits are not reproduced here.
Relative repeatability | b | 1.00
Relative reversibility | v | 1.50
Relative zero error | f0 | 0.10
Relative resolution | a | 0.50
HARNESS READOUT — test 0 pastes here | PASTE AT B36 | Check
Harness firmware version | Harness V1 |  | Ki (PWM per kg*s) | 10
Slope k flashed (kg per count) | 0.0000583277 | matches LC_Reference | PI output limit (PWM, 0-255 scale) | 100
Intercept c flashed (kg) | 0.145367338 | c without plate: flash LC_Reference!B28 for future use | Hold band below target (kg) | 0.05
ADC reference mode | ratiometric | OK - matches PCB rev 2 | Hold band above target (kg) | 0.25
Motor PWM frequency (Hz) | 20000 |  | Control period (ms) | 20
Driver temperature at power-on (deg C) | 23.9 | close to ambient: rig was cold | ADC rate (SPS, averaged per period) | 350
Current-sensor zero (mV) | 1597 | OK | PWM bits (at MOTOR_PWM_FREQ_HZ) | 10
Current-sensor sensitivity (mV/A) | 26.4
Setpoint cap (kg) | 90.0 | OK
Kp (PWM per kg) | 6.00
Deadband (kg) | 0.40 | matches B23
Overload trip (kg) | 95.0
Overcurrent trip (A) | 8.0 | above the highest current in T11
Current clamp (A) | 6.0
Driver temperature warning (deg C) | 70.0
Driver temperature trip (deg C) | 85.0
Settling confirmation window (ms) | 2000
^ LAST PASTE ROW (52).
Class limits entered? | yes - verdicts active
Ki (PWM per kg*s) 10.00
PI output limit (PWM, 0-255 scale) 100
Hold band below target (kg) 0.05
Hold band above target (kg) 0.25
Control period (ms) 20
ADC rate (SPS, averaged per period) 350
PWM bits (at MOTOR_PWM_FREQ_HZ) 10

Sheet: LC_Reference
LC_REFERENCE — values carried forward from the load-cell UTM calibration
WHAT THIS IS: the ONLY place results from Load_Cell_Calibration_Data_V1.xlsx enter this workbook.
HOW TO USE: in that workbook, sheet Analysis, copy the two ORANGE export blocks and Paste Special > Values
into the two ORANGE blocks below (A) Analysis!N20:N26 -> B20 and (B) Analysis!P4:X14 -> A31.
Never link live to the other file. Then flash B20 and B21 into the harness AND the rig firmware.
The UTM session must use THIS PCB with the ratiometric reference; counts from another board do not apply.
KEY: GREEN = paste from the serial monitor | ORANGE = carry forward from the load-cell workbook | YELLOW, blue text = type by hand | GREY = helper, do not type | white = calculated
PROVENANCE | Value | Note
Source workbook and version | Load_Cell_Calibration_Data_V1 | file name you copied from
UTM calibration date | 15:10:26
UTM identity and certificate no.
ADC reference during the UTM session | 5.000V | must be 'ratiometric'
PCB / board used | RIGOR V2.1 | must be the board in the rig
BLOCK A — CARRY FORWARD: paste Analysis!N20:N26 at B20 |  | Unit | Source in the load-cell workbook
Slope k | 0.0000583277 | kg per count | Analysis!N20
Intercept c | 0.145367338 | kg | Analysis!N21
R squared of the fit | 0.999989 | - | Analysis!N22
Residual SD of the fit | 0.1098 | kg | Analysis!N23
Max |hysteresis| (up vs down) | 0.0163 | kg | Analysis!N24
Zero-return spread | 0.0066 | kg | Analysis!N25
Rounds included in the fit | 3 | count | Analysis!N26
Sensitivity (calculated) | 17144.5 | counts per kg
Intercept for the RIG = c + plate mass (flash as CAL_INTERCEPT_KG) | 0.4 | kg
BLOCK B — CARRY FORWARD: paste Analysis!P4:X14 at A31 (11 levels)
Nominal (kg) | R1 up ref (kg) | R1 up counts | R2 up ref (kg) | R2 up counts | R3 up ref (kg) | R3 up counts | Down ref, mean (kg) | Down counts, mean | Ind. R1 (kg) | Ind. R2 (kg) | Ind. R3 (kg) | q1 (%) | q2 (%) | q3 (%) | q mean (%) | b (%) | Ind. down (kg) | Ind. up mean (kg) | v (%) | Verdict
0.000 | 0.000 | -6 | 0.000 | 326 | 0.000 | 398 | 0.000 | 386.3333333 | 0.145 | 0.164 | 0.169 |  |  |  |  |  | 0.168 | 0.159
10.000 | 10.187 | 173923 | 10.177 | 173055 | 10.187 | 173189 | 10.173 | 173141 | 10.290 | 10.239 | 10.247 | 1.010 | 0.614 | 0.590 | 0.738 | 0.420 | 10.244 | 10.259 | -0.142 | PASS
20.000 | 20.374 | 347480 | 20.354 | 346702 | 20.374 | 346457 | 20.374 | 346711 | 20.413 | 20.368 | 20.353 | 0.192 | 0.070 | -0.101 | 0.054 | 0.293 | 20.368 | 20.378 | -0.048 | PASS
30.000 | 30.561 | 521197 | 30.561 | 520638 | 30.581 | 520420 | 30.574 | 520472 | 30.546 | 30.513 | 30.500 | -0.050 | -0.157 | -0.265 | -0.157 | 0.215 | 30.503 | 30.520 | -0.053 | PASS
40.000 | 40.768 | 695062 | 40.778 | 694597 | 40.748 | 694484 | 40.778 | 694734.6667 | 40.687 | 40.660 | 40.653 | -0.200 | -0.291 | -0.233 | -0.241 | 0.091 | 40.668 | 40.666 | 0.003 | PASS
50.000 | 50.965 | 869398 | 50.965 | 869001 | 50.955 | 868905 | 50.962 | 869322.6667 | 50.855 | 50.832 | 50.827 | -0.216 | -0.261 | -0.252 | -0.243 | 0.045 | 50.851 | 50.838 | 0.025 | PASS
60.000 | 61.142 | 1044107 | 61.163 | 1043854 | 61.173 | 1043979 | 61.166 | 1044056.333 | 61.046 | 61.031 | 61.038 | -0.158 | -0.215 | -0.220 | -0.198 | 0.062 | 61.043 | 61.038 | 0.007 | PASS
70.000 | 71.350 | 1219246 | 71.339 | 1219307 | 71.360 | 1219013 | 71.363 | 1219393 | 71.261 | 71.265 | 71.248 | -0.124 | -0.105 | -0.157 | -0.128 | 0.053 | 71.270 | 71.258 | 0.017 | PASS
80.000 | 81.496 | 1394951 | 81.557 | 1395397 | 81.537 | 1394976 | 81.540 | 1395223.333 | 81.510 | 81.536 | 81.511 | 0.017 | -0.026 | -0.031 | -0.013 | 0.048 | 81.526 | 81.519 | 0.008 | PASS
90.000 | 91.744 | 1571660 | 91.744 | 1571453 | 91.703 | 1571546 | 91.737 | 1571777.667 | 91.817 | 91.805 | 91.810 | 0.079 | 0.066 | 0.117 | 0.087 | 0.050 | 91.824 | 91.810 | 0.014 | PASS
100.000 | 99.891 | 1712976 | 99.871 | 1713228 | 99.891 | 1713577 | 99.895 | 1713255 | 100.059 | 100.074 | 100.094 | 0.168 | 0.203 | 0.203 | 0.192 | 0.035 | 100.076 | 100.076 | -0.0003114088521 | PASS
^ LAST CARRY-FORWARD ROW (41). Excluded rounds arrive blank; that is correct.
 |  |  |  |  |  |  |  |  | q per round = (indicated - UTM) / UTM x 100, increasing series. b = spread of q across rounds. v = (indicated decreasing - mean indicated increasing) / UTM x 100. Zero level excluded from q.
ISO 7500-1 WORST CASE OVER THE RANGE (from the UTM data)
 | Value (%) | Limit (%) | Verdict
Relative indication error q | 0.738 | 1.00 | PASS
Relative repeatability b | 0.420 | 1.00 | PASS
Relative reversibility v | 0.142 | 1.50 | PASS
Relative zero error f0 | 0.025 | 0.10 | PASS
f0 = residual zero indication after the decreasing series, relative to the zero set before series 1 (ISO 7500-1 Cl. 6.4.5: zero is set before the series). The plate is a constant dead load and cancels.
Plate mass implied by the counts: UTM zero (row 31) minus rig unloaded reading (T1 cond. 2), kg -> |  |  |  | 0.2

Sheet: T1_Noise_Resolution
T1 — RESOLUTION AND NOISE FLOOR
Harness menu 1 -> paste at A13 (4 rows)
WHAT IT SHOWS: noise in four states. 1 vs 2 isolates ELECTRICAL noise from the energised driver; 3 vs 4 repeats
that seated on a preload; 1 vs 3 shows MECHANICAL noise from the load path. Current noise is logged alongside.
ISO 7500-1 Cl. 6.2.3: if the unloaded reading moves by more than one increment, resolution is HALF the p-p range.
The harness walks you through the e-stop presses. Run after the warm-up period (T6).
KEY: GREEN = paste from the serial monitor | ORANGE = carry forward from the load-cell workbook | YELLOW, blue text = type by hand | GREY = helper, do not type | white = calculated
1 | 2000 | 0.78821 | 0.00412 | 0.77501 | 0.80112 | 0.02611 | -12189.4 | 78.1 | 0.002 | 0.011 | 24.6 | <- example of a pasted row (not used)
Cond. | n | Mean (kg) | SD (kg) | Min (kg) | Max (kg) | p-p (kg) | Mean counts | SD counts | Mean current (A) | SD current (A) | Driver temp (C) | Half p-p (kg) | Condition | DECLARED RESOLUTION
1 | 2000 | -0.08178 | 0.00151 | -0.08678 | -0.07674 | 0.01003 | -3894.4 | 25.9 | 0.072 | 0.043 | 32.1 | 0.00502 | Idle, no load, motor power OFF | Display increment of the indicator (kg) | 0.010
2 | 2000 | -0.08065 | 0.00154 | -0.08544 | -0.07587 | 0.00957 | -3874.9 | 26.4 | 0.067 | 0.046 | 32.1 | 0.00479 | Idle, no load, motor power ON (PWM 0) | Half p-p, UNLOADED, drive energised (Cl. 6.2.3) (kg) | 0.00479
3 | 2000 | 4.74392 | 0.00905 | 4.72538 | 4.77251 | 0.04713 | 78840 | 155.2 | 0.07 | 0.046 | 31.7 | 0.02356 | Seated on preload, motor power OFF | Declared resolution r (kg) | 0.01000 | kg | the larger of the two, Cl. 6.2.3
4 | 2000 | 4.82015 | 0.03114 | 4.77816 | 4.91232 | 0.13415 | 80146.8 | 533.9 | 0.08 | 0.048 | 31.7 | 0.06707 | Seated on preload, motor power ON, loop stopped
^ LAST PASTE ROW (16). Nothing below this is read. |  |  |  |  |  |  |  |  |  |  |  |  |  | ELECTRICAL vs MECHANICAL
 |  |  |  |  |  |  |  |  |  |  |  |  |  | SD increase, driver energised, free (kg) | 0.00003
 |  |  |  |  |  |  |  |  |  |  |  |  |  | SD increase, driver energised, seated (kg) | 0.02209
 |  |  |  |  |  |  |  |  |  |  |  |  |  | SD increase from seating, driver off (kg) | 0.00754
 |  |  |  |  |  |  |  |  |  |  |  |  |  | Current-sensor noise, driver on (A) | 0.046
 |  |  |  |  |  |  |  |  |  |  |  |  |  | RELATIVE RESOLUTION a = r / F x 100
 |  |  |  |  |  |  |  |  |  |  |  |  |  | Nominal force (kg) | a (%) | Limit (%) | Verdict
 |  |  |  |  |  |  |  |  |  |  |  |  |  | 5 | 0.200 | 0.5 | PASS
 |  |  |  |  |  |  |  |  |  |  |  |  |  | 10 | 0.100 | 0.5 | PASS
 |  |  |  |  |  |  |  |  |  |  |  |  |  | 20 | 0.050 | 0.5 | PASS
 |  |  |  |  |  |  |  |  |  |  |  |  |  | 30 | 0.033 | 0.5 | PASS
 |  |  |  |  |  |  |  |  |  |  |  |  |  | 40 | 0.025 | 0.5 | PASS
 |  |  |  |  |  |  |  |  |  |  |  |  |  | 50 | 0.020 | 0.5 | PASS
 |  |  |  |  |  |  |  |  |  |  |  |  |  | 60 | 0.017 | 0.5 | PASS
 |  |  |  |  |  |  |  |  |  |  |  |  |  | 65 | 0.015 | 0.5 | PASS

Sheet: T2_Command_Accuracy
T2 — COMMANDED VERSUS ACHIEVED FORCE
Harness menu 2 -> paste at the first empty green row (A13 for the first run)
WHAT IT SHOWS: the force the rig actually reaches when told a setpoint. Each repetition starts from a common
unloaded position. This is the generating accuracy a user relies on; ISO 7500-1 does not cover it.
Failed approaches arrive with Achieved blank and are counted, not hidden.
Error is given relative to the setpoint and relative to F_N; at low setpoints the relative figure is large.
KEY: GREEN = paste from the serial monitor | ORANGE = carry forward from the load-cell workbook | YELLOW, blue text = type by hand | GREY = helper, do not type | white = calculated
20 | 1 | 19.8213 | 5340 | 2.15 | 2.41 | 1.37 | 31.2 | <- example of a pasted row (not used)
Setpoint (kg) | Rep | Achieved (kg) | Settle (ms) | Overshoot (%) | I peak (A) | I mean moving (A) | Driver temp (C) | Error (kg) | Error (%) | Error (%FS) | |Error| %FS (helper) | Achieved^2 (helper) | distinct # (helper) | Setpoint (kg) | n | Mean achieved (kg) | Mean error (kg) | SD achieved (kg) | Worst |err| (%FS) | Mean settle (s) | Mean overshoot (%) | Max I peak (A)
5.00 | 1 | 4.9589 | 9680 | 0.00 | 0.38 | 0.21 | 32.2 | -0.041 | -0.822 | -0.046 | 0.04566666667 | 24.59068921 | 1 | 5.00 | 5 | 5.0601 | 0.0601 | 0.0578 | 0.107 | 6.62 | 4.31 | 0.38
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
90.00 | 4 | 89.9695 | 36400 | 1.24 | 1.31 | 0.19 | 32.6 | -0.031 | -0.034 | -0.034 | 0.03388888889 | 8094.51093
90.00 | 5 | 89.9505 | 19600 | 1.33 | 1.36 | 0.22 | 32.6 | -0.049 | -0.055 | -0.055 | 0.055 | 8091.09245
^ LAST PASTE ROW (212). Nothing below this is read.

Sheet: T3_Repeatability
T3 — SHORT-TERM REPEATABILITY
Harness menu 3 -> paste at the first empty green row (A13 for the first run)
WHAT IT SHOWS: scatter of repeated approaches to ONE setpoint with nothing disturbed. Run once per setpoint and
paste each run below the last. It excludes fixturing, so it is the optimistic figure; T4 adds reseating.
Ten trials is the practical minimum for a usable standard deviation.
KEY: GREEN = paste from the serial monitor | ORANGE = carry forward from the load-cell workbook | YELLOW, blue text = type by hand | GREY = helper, do not type | white = calculated
30 | 1 | 29.8721 | 6120 | 2.83 | 32 | <- example of a pasted row (not used)
Setpoint (kg) | Trial | Achieved (kg) | Settle (ms) | I peak (A) | Driver temp (C) | Achieved^2 (helper) | distinct # (helper) | Setpoint (kg) | n | Mean (kg) | SD (kg) | CV (%) | Range (kg) | SD (%FS) | Mean settle (s)
30.00 | 1 | 29.9803 | 22380 | 0.48 | 32.5 | 898.8183881 | 1 | 30.00 | 10 | 30.0406 | 0.0815 | 0.271 | 0.2186 | 0.091 | 14.60
30.00 | 2 | 29.9909 | 6980 | 0.53 | 32.5 | 899.4540828 |  | 50.00 | 10 | 50.0944 | 0.1742 | 0.348 | 0.4611 | 0.194 | 17.46
30.00 | 3 | 30.1143 | 14000 | 0.50 | 32.6 | 906.8710645 |  | 90.00 | 10 | 90.0449 | 0.0554 | 0.062 | 0.1806 | 0.062 | 27.88
30.00 | 4 | 30.1668 | 24140 | 0.53 | 32.6 | 910.0358222
30.00 | 5 | 30.1614 | 15040 | 0.55 | 32.6 | 909.71005
30.00 | 6 | 29.9989 | 5880 | 0.56 | 32.6 | 899.9340012
30.00 | 7 | 30.0385 | 12120 | 0.49 | 32.7 | 902.3114823
30.00 | 8 | 29.9552 | 17400 | 0.53 | 32.7 | 897.314007
30.00 | 9 | 29.9482 | 13320 | 0.53 | 32.7 | 896.8946832
30.00 | 10 | 30.0518 | 14740 | 0.52 | 32.7 | 903.1106832
50.00 | 1 | 50.1975 | 25360 | 0.87 | 32.7 | 2519.789006 | 2
50.00 | 2 | 50.3095 | 8260 | 0.83 | 32.7 | 2531.04579
50.00 | 3 | 49.8865 | 6640 | 0.82 | 32.7 | 2488.662882 |  | OVERALL
50.00 | 4 | 50.3476 | 6140 | 0.83 | 32.8 | 2534.880826 |  | Worst CV (%) | 0.348 | %
50.00 | 5 | 50.2460 | 5560 | 0.83 | 32.8 | 2524.660516 |  | Worst SD (kg) | 0.1742 | kg
50.00 | 6 | 50.1459 | 5860 | 0.85 | 32.8 | 2514.611287 |  | Worst SD (%FS) | 0.194 | %FS
50.00 | 7 | 49.9687 | 5560 | 0.80 | 32.9 | 2496.87098
50.00 | 8 | 49.9316 | 57840 | 0.86 | 32.7 | 2493.164679
50.00 | 9 | 49.9231 | 24360 | 0.83 | 32.7 | 2492.315914
50.00 | 10 | 49.9872 | 29000 | 0.80 | 32.7 | 2498.720164
90.00 | 1 | 90.0205 | 20840 | 1.37 | 32.7 | 8103.69042 | 3
90.00 | 2 | 90.0577 | 12200 | 1.33 | 32.7 | 8110.389329
90.00 | 3 | 90.1009 | 38600 | 1.34 | 32.7 | 8118.172181
90.00 | 4 | 90.0470 | 44420 | 1.34 | 32.7 | 8108.462209
90.00 | 5 | 90.1557 | 14660 | 1.30 | 32.7 | 8128.050242
90.00 | 6 | 89.9751 | 23900 | 1.28 | 32.7 | 8095.51862
90.00 | 7 | 89.9977 | 29060 | 1.34 | 32.7 | 8099.586005
90.00 | 8 | 89.9875 | 31342 | 1.30 | 32.7 | 8097.750156
90.00 | 9 | 90.0750 | 37980 | 1.29 | 32.7 | 8113.505625
90.00 | 10 | 90.0317 | 25820 | 1.27 | 32.7 | 8105.707005
^ LAST PASTE ROW (212). Nothing below this is read.

Sheet: T4_Seating_GageRR
T4 — SEATING REPRODUCIBILITY AND GAUGE R&R
Harness menu 4 -> paste at the first empty green row (A13 for the first run)
WHAT IT SHOWS: variation when the load path is fully RESEATED before every trial, which is what a user meets
between sessions. Run once per operator with the SAME three setpoints; paste each run below the last.
Crossed ANOVA Gauge R&R (operators x setpoints x trials). Setpoints play the role of 'parts', so %GRR is
measured against widely spaced loads and looks small: report it TOGETHER with the GRR standard deviation in kg.
One operator only: reproducibility is zero by construction; report repeatability-with-reseating only.
KEY: GREEN = paste from the serial monitor | ORANGE = carry forward from the load-cell workbook | YELLOW, blue text = type by hand | GREY = helper, do not type | white = calculated
1 | 30 | 1 | 29.7712 | 6540 | 31.8 | <- example of a pasted row (not used)
Operator | Setpoint (kg) | Trial | Achieved (kg) | Settle (ms) | Driver temp (C) | Achieved^2 (helper) | distinct # (helper) | distinct # (helper) | CELL MEANS (kg) operator \ setpoint
1 | 10.00 | 1 | 10.0064 | 11721 | 32.2 | 100.128041 | 1 | 1
1 | 40.00 | 1 | 40.0708 | 10221 | 32.3 | 1605.669013 |  | 2 | Setpoint -> | 10 | 40 | 70
1 | 70.00 | 1 | 69.9584 | 41141 | 32.4 | 4894.177731 |  | 3 | 1 | 10.0151 | 40.1627 | 70.0182
1 | 10.00 | 2 | 10.0163 | 5081 | 32.4 | 100.3262657 |  |  | 2 | 10.0510 | 40.1141 | 70.0453
1 | 40.00 | 2 | 40.3629 | 5201 | 32.4 | 1629.163696
1 | 70.00 | 2 | 70.0445 | 26181 | 32.4 | 4906.23198
1 | 10.00 | 3 | 10.0226 | 4641 | 32.4 | 100.4525108 |  |  | TRIALS PER CELL
1 | 40.00 | 3 | 40.0544 | 6921 | 32.5 | 1604.354959 |  |  | 1 | 3 | 3 | 3
1 | 70.00 | 3 | 70.0517 | 9021 | 32.5 | 4907.240673 |  |  | 2 | 3 | 3 | 3
2 | 10.00 | 1 | 10.0486 | 9621 | 32.4 | 100.974362 | 2
2 | 40.00 | 1 | 40.1659 | 5761 | 32.5 | 1613.299523
2 | 70.00 | 1 | 69.9948 | 15741 | 32.5 | 4899.272027 |  |  | SQUARED DEVIATION OF CELL MEANS (helper)
2 | 10.00 | 2 | 10.1266 | 4681 | 32.5 | 102.5480276 |  |  |  | 903.1611042 | 0.009017612623 | 897.0301208
2 | 40.00 | 2 | 40.0756 | 9501 | 32.5 | 1606.053715 |  |  |  | 901.0026124 | 0.002152444475 | 898.6521717
2 | 70.00 | 2 | 70.1940 | 23261 | 32.5 | 4927.197636 |  |  |  | 0 | 0 | 0
2 | 10.00 | 3 | 9.9779 | 4561 | 32.5 | 99.55848841
2 | 40.00 | 3 | 40.1009 | 16361 | 32.6 | 1608.082181 |  |  | DESIGN
2 | 70.00 | 3 | 69.9470 | 46541 | 32.5 | 4892.582809 |  |  | Operators a | 2
 |  |  |  |  |  |  |  |  | Setpoints b | 3
 |  |  |  |  |  |  |  |  | Readings N | 18
 |  |  |  |  |  |  |  |  | Trials per cell n | 3.00
 |  |  |  |  |  |  |  |  | Balanced design? | yes
 |  |  |  |  |  |  |  |  | Grand mean (kg) | 40.0677
 |  |  |  |  |  |  |  |  | OPERATOR MEANS |  | sq. dev (helper)
 |  |  |  |  |  |  |  |  | 1 | 40.0653 | 5.786697531e-06
 |  |  |  |  |  |  |  |  | 2 | 40.0701 | 5.786697531e-06
 |  |  |  |  |  |  |  |  |  |  | 0
 |  |  |  |  |  |  |  |  | SETPOINT MEANS |  | sq. dev (helper)
 |  |  |  |  |  |  |  |  | 10 | 10.0331 | 902.0815355
 |  |  |  |  |  |  |  |  | 40 | 40.1384 | 0.004995348272
 |  |  |  |  |  |  |  |  | 70 | 70.0317 | 897.8409631
 |  |  |  |  |  |  |  |  | ANOVA | SS | df | MS
 |  |  |  |  |  |  |  |  | Operators | 0.000104 | 1 | 0.000104
 |  |  |  |  |  |  |  |  | Setpoints | 10799.564963 | 2 | 5399.782482
 |  |  |  |  |  |  |  |  | Interaction | 0.006470 | 2 | 0.003235
 |  |  |  |  |  |  |  |  | Repeatability (error) | 0.115507 | 12 | 0.009626
 |  |  |  |  |  |  |  |  | Total | 10799.687044 | 17 | 635.275708
 |  |  |  |  |  |  |  |  | VARIANCE COMPONENTS (kg^2)
 |  |  |  |  |  |  |  |  | Repeatability s2_e | 0.009626
 |  |  |  |  |  |  |  |  | Interaction s2_oxp | 0.000000
 |  |  |  |  |  |  |  |  | Operator s2_o | 0.000000
 |  |  |  |  |  |  |  |  | Setpoint ('part') s2_p | 899.963208
 |  |  |  |  |  |  |  |  | RESULT
 |  |  |  |  |  |  |  |  | Repeatability SD, with reseating (kg) | 0.0981 | kg
 |  |  |  |  |  |  |  |  | Reproducibility SD, operators (kg) | 0.0000 | kg
 |  |  |  |  |  |  |  |  | Gauge R&R SD (kg) | 0.0981 | kg | feeds T13 u_seat
 |  |  |  |  |  |  |  |  | Gauge R&R SD (%FS) | 0.109 | %FS
 |  |  |  |  |  |  |  |  | %GRR (of total variation) | 0.33 | %
 |  |  |  |  |  |  |  |  | Distinct categories ndc | 431.1
 |  |  |  |  |  |  |  |  | Verdict (AIAG) | acceptable (<10 %)
^ LAST PASTE ROW (212). Nothing below this is read.

Sheet: T5_Direction
T5 — DIRECTION DEPENDENCE (BACKLASH + DEADBAND)
Harness menu 5 -> paste at the first empty green row (A13 for the first run)
WHAT IT SHOWS: the same setpoint reached from BELOW (from unloaded) and from ABOVE (after settling at 110 %).
The gap bounds mechanical backlash plus controller deadband. A gap close to the deadband width is expected.
This is a property of the CONTROL loop. Measurement-chain hysteresis comes from the UTM data (LC_Reference).
KEY: GREEN = paste from the serial monitor | ORANGE = carry forward from the load-cell workbook | YELLOW, blue text = type by hand | GREY = helper, do not type | white = calculated
30 | 1 | 29.7811 | 30.2104 | 2.71 | 1.92 | 32.4 | <- example of a pasted row (not used)
Setpoint (kg) | Rep | From below (kg) | From above (kg) | I peak below (A) | I peak above (A) | Driver temp (C) | Delta below-above (kg) | |Delta| (helper) | % of deadband width | distinct # (helper) | Setpoint (kg) | n | Mean below (kg) | Mean above (kg) | Mean delta (kg) | Worst |delta| (kg) | Worst % of band
10.00 | 1 | 9.9660 | 10.0227 | 0.44 | 0.20 | 32.6 | -0.0567 | 0.0567 | 7.1 | 1 | 10 | 3 | 10.0360 | 10.0576 | -0.0216 | 0.1110 | 13.9
10.00 | 2 | 10.1301 | 10.0273 | 0.36 | 0.24 | 32.6 | 0.1028 | 0.1028 | 12.8 |  | 40 | 3 | 40.0765 | 40.1793 | -0.1028 | 0.2040 | 25.5
10.00 | 3 | 10.0119 | 10.1229 | 0.32 | 0.23 | 32.6 | -0.1110 | 0.111 | 13.9 |  | 70 | 3 | 70.0883 | 69.9593 | 0.1290 | 0.2634 | 32.9
40.00 | 1 | 40.0140 | 40.2110 | 0.72 | 0.22 | 32.6 | -0.1970 | 0.197 | 24.6 | 2
40.00 | 2 | 40.1897 | 40.0971 | 0.64 | 0.19 | 32.6 | 0.0926 | 0.0926 | 11.6
40.00 | 3 | 40.0259 | 40.2299 | 0.73 | 0.18 | 32.7 | -0.2040 | 0.204 | 25.5
70.00 | 1 | 69.9525 | 69.9651 | 1.07 | 0.51 | 32.6 | -0.0126 | 0.0126 | 1.6 | 3
70.00 | 2 | 70.2175 | 69.9541 | 1.04 | 0.48 | 32.6 | 0.2634 | 0.2634 | 32.9
70.00 | 3 | 70.0950 | 69.9587 | 1.02 | 0.45 | 32.6 | 0.1363 | 0.1363 | 17.0
 |  |  |  |  |  |  |  |  |  |  | OVERALL
 |  |  |  |  |  |  |  |  |  |  | Worst |delta| (kg) | 0.2634 | kg
 |  |  |  |  |  |  |  |  |  |  | Worst |delta| (%FS) | 0.293 | %FS
 |  |  |  |  |  |  |  |  |  |  | Mean delta (kg) | 0.0015 | kg
^ LAST PASTE ROW (112). Nothing below this is read.

Sheet: T6_Warmup_Drift
T6 — WARM-UP AND ZERO DRIFT, UNLOADED, FROM COLD
Harness menu 6 -> paste at A13 (one run per sheet, up to 1000 rows)
WHAT IT SHOWS: how long the rig takes to stabilise from cold. Run it FIRST in the session (after test 0): every
other measurement is taken after the warm-up period declared here.
Each row is the average of every conversion in its interval (default 10 s, 60 min = 361 rows).
The harness announces when force AND driver temperature have been stable for 10 minutes. Type that time into I17,
after checking it against the chart.
KEY: GREEN = paste from the serial monitor | ORANGE = carry forward from the load-cell workbook | YELLOW, blue text = type by hand | GREY = helper, do not type | white = calculated
600 | 0.78642 | -12266 | 0.001 | 27.4 | 0 | <- example of a pasted row (not used)
Elapsed (s) | Force (kg) | Counts | Mean |I| (A) | Driver temp (C) | PWM on (%) |  | SUMMARY | Value | Unit
0 | -0.08339 | -3922 | 0.001 | 26.21 | 0 |  | Reading at t = 0 | -0.08339 | kg
10 | -0.08314 | -3917.7 | 0.011 | 26.39 | 0 |  | Reading at end | -0.09966 | kg
20 | -0.08504 | -3950.2 | 0.009 | 26.49 | 0 |  | Total excursion | 0.02152 | kg
30 | -0.08633 | -3972.4 | 0.009 | 26.59 | 0 |  | Total excursion (%FS) | 0.024 | %FS
40 | -0.08727 | -3988.5 | 0.012 | 26.67 | 0 |  | Declared warm-up period | 28.3 | min | TYPE IT: the harness prints a suggestion ('STABLE ... after X min'); confirm it on the chart
50 | -0.08802 | -4001.4 | 0.009 | 26.77 | 0 |  | Reading at end of warm-up | -0.10127 | kg
60 | -0.08867 | -4012.5 | 0.01 | 26.85 | 0 |  | Record length | 60.0 | min
70 | -0.08911 | -4020 | 0.009 | 26.93 | 0 |  | Residual drift after warm-up | 0.00305 | kg/h | end minus end-of-warm-up, per hour
80 | -0.08951 | -4026.9 | 0.01 | 27.02 | 0 |  | Excursion after warm-up | 0.00329 | kg
90 | -0.09005 | -4036.1 | 0.009 | 27.09 | 0 |  | Driver temperature at start | 26.2 | C
100 | -0.09041 | -4042.3 | 0.011 | 27.16 | 0 |  | Driver temperature at end of warm-up | 30.8 | C
110 | -0.09066 | -4046.6 | 0.011 | 27.22 | 0 |  | Driver temperature at end | 31.9 | C
120 | -0.09098 | -4052.1 | 0.01 | 27.27 | 0 |  | Driver temperature rise, whole record | 5.7 | C
130 | -0.09149 | -4060.8 | 0.01 | 27.34 | 0 |  | Mean motor current (should be ~0) | 0.011 | A
140 | -0.09161 | -4062.9 | 0.011 | 27.41 | 0
150 | -0.09188 | -4067.4 | 0.011 | 27.45 | 0
160 | -0.09218 | -4072.7 | 0.01 | 27.5 | 0
170 | -0.09269 | -4081.4 | 0.01 | 27.56 | 0
180 | -0.09279 | -4083 | 0.011 | 27.64 | 0
190 | -0.09327 | -4091.3 | 0.012 | 27.72 | 0
200 | -0.09333 | -4092.4 | 0.012 | 27.78 | 0
210 | -0.09339 | -4093.3 | 0.011 | 27.83 | 0
220 | -0.09359 | -4096.8 | 0.011 | 27.87 | 0
230 | -0.09366 | -4098 | 0.011 | 27.91 | 0
240 | -0.09362 | -4097.3 | 0.01 | 27.95 | 0
250 | -0.09385 | -4101.3 | 0.01 | 28 | 0
260 | -0.09399 | -4103.6 | 0.012 | 28.06 | 0
270 | -0.09404 | -4104.4 | 0.01 | 28.1 | 0
280 | -0.09393 | -4102.7 | 0.01 | 28.15 | 0
290 | -0.09417 | -4106.7 | 0.01 | 28.18 | 0
300 | -0.09439 | -4110.6 | 0.01 | 28.21 | 0
310 | -0.09462 | -4114.5 | 0.01 | 28.24 | 0
320 | -0.09487 | -4118.8 | 0.011 | 28.27 | 0
330 | -0.09501 | -4121.1 | 0.011 | 28.29 | 0
340 | -0.09475 | -4116.7 | 0.011 | 28.32 | 0
350 | -0.09474 | -4116.5 | 0.01 | 28.35 | 0
360 | -0.09477 | -4117.1 | 0.012 | 28.38 | 0
370 | -0.09462 | -4114.5 | 0.011 | 28.42 | 0
380 | -0.09445 | -4111.5 | 0.01 | 28.46 | 0
390 | -0.09458 | -4113.7 | 0.011 | 28.5 | 0
400 | -0.09491 | -4119.4 | 0.01 | 28.54 | 0
410 | -0.09528 | -4125.8 | 0.012 | 28.58 | 0
420 | -0.09549 | -4129.4 | 0.01 | 28.62 | 0
430 | -0.09566 | -4132.3 | 0.012 | 28.64 | 0
440 | -0.09593 | -4136.9 | 0.01 | 28.66 | 0
450 | -0.09584 | -4135.4 | 0.01 | 28.69 | 0
460 | -0.09593 | -4137 | 0.01 | 28.71 | 0
470 | -0.09596 | -4137.5 | 0.01 | 28.74 | 0
480 | -0.09604 | -4138.8 | 0.011 | 28.76 | 0
490 | -0.09605 | -4138.9 | 0.009 | 28.78 | 0
500 | -0.09616 | -4140.8 | 0.01 | 28.81 | 0
510 | -0.09611 | -4140 | 0.01 | 28.84 | 0
520 | -0.09618 | -4141.2 | 0.011 | 28.89 | 0
530 | -0.09635 | -4144.1 | 0.012 | 28.93 | 0
540 | -0.09641 | -4145.2 | 0.011 | 28.95 | 0
550 | -0.09646 | -4146 | 0.01 | 28.98 | 0
560 | -0.09654 | -4147.4 | 0.011 | 29.01 | 0
570 | -0.09663 | -4149 | 0.012 | 29.04 | 0
580 | -0.09673 | -4150.7 | 0.011 | 29.05 | 0
590 | -0.09689 | -4153.3 | 0.01 | 29.07 | 0
600 | -0.09691 | -4153.7 | 0.01 | 29.09 | 0
610 | -0.09694 | -4154.2 | 0.012 | 29.11 | 0
620 | -0.09702 | -4155.6 | 0.011 | 29.14 | 0
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
3550 | -0.09976 | -4202.6 | 0.012 | 31.9 | 0
3560 | -0.09973 | -4202.1 | 0.01 | 31.91 | 0
3570 | -0.09957 | -4199.4 | 0.01 | 31.9 | 0
3580 | -0.09977 | -4202.7 | 0.011 | 31.91 | 0
3590 | -0.09951 | -4198.3 | 0.011 | 31.91 | 0
3600 | -0.09966 | -4200.9 | 0.01 | 31.91 | 0
^ LAST PASTE ROW (1012). Nothing below this is read.

Sheet: T7_Creep_LoopOn
T7 — CREEP UNDER SUSTAINED LOAD, CONTROL LOOP ON
Harness menu 7 -> paste at A13 (one run per sheet, up to 1000 rows)
WHAT IT SHOWS: how the held force wanders over 30+ minutes while the loop keeps regulating: creep as a user sees it.
Mean |current| and PWM on-time show how hard the loop works to hold the load. Run after the warm-up period.
Compare with T8: the difference separates control-loop behaviour from mechanical relaxation of the load path.
KEY: GREEN = paste from the serial monitor | ORANGE = carry forward from the load-cell workbook | YELLOW, blue text = type by hand | GREY = helper, do not type | white = calculated
600 | 0.78642 | -12266 | 0.001 | 27.4 | 0 | <- example of a pasted row (not used)
Elapsed (s) | Force (kg) | Counts | Mean |I| (A) | Driver temp (C) | PWM on (%) |  | SUMMARY | Value | Unit
0 | 29.99266 | 511717 | 0.018 | 32.55 | 0.0 |  | Sustained load (setpoint) | 30.00 | kg | TYPE the setpoint you ran
10 | 30.04841 | 512672.8 | 0.019 | 32.56 | 3.0 |  | Reading at t = 0 (first settled sample) | 29.99266 | kg
20 | 30.07840 | 513187 | 0.020 | 32.55 | 3.2 |  | Reading at 30 min | 29.96464 | kg | last sample at or before 1800 s
30 | 30.16549 | 514680.1 | 0.013 | 32.54 | 0.4 |  | Reading at end | 29.95674 | kg
40 | 30.10701 | 513677.4 | 0.012 | 32.54 | 0.0 |  | Creep over 30 min | -0.02802 | kg | feeds T13 u_drift and Summary
50 | 30.06518 | 512960.4 | 0.018 | 32.53 | 2.2 |  | Creep over 30 min (%FS) | -0.031 | %FS
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
2060 | 29.96512 | 511244.8 | 0.012 | 32.50 | 0.0
2070 | 29.96348 | 511216.7 | 0.011 | 32.50 | 0.0
2080 | 29.96133 | 511179.8 | 0.011 | 32.49 | 0.0
2090 | 29.95892 | 511138.5 | 0.010 | 32.49 | 0.0
2100 | 29.95674 | 511101.1 | 0.012 | 32.49 | 0.0
^ LAST PASTE ROW (1012). Nothing below this is read.

Sheet: T8_Creep_LoopOff
T8 — CREEP WITH THE LOOP STOPPED AFTER SETTLING
Harness menu 8 -> paste at A13 (one run per sheet, up to 1000 rows)
WHAT IT SHOWS: after settling the motor stops and the self-locking leadscrew holds position. Any change in force
is mechanical relaxation of the load path and specimen, not control. Use the same load as T7.
KEY: GREEN = paste from the serial monitor | ORANGE = carry forward from the load-cell workbook | YELLOW, blue text = type by hand | GREY = helper, do not type | white = calculated
600 | 0.78642 | -12266 | 0.001 | 27.4 | 0 | <- example of a pasted row (not used)
Elapsed (s) | Force (kg) | Counts | Mean |I| (A) | Driver temp (C) | PWM on (%) |  | SUMMARY | Value | Unit
0 | 30.14857 | 514390 | 0.033 | 32.33 | 0.0 |  | Sustained load (setpoint) | 30.00 | kg | TYPE the setpoint you ran
10 | 29.98191 | 511532.7 | 0.010 | 32.38 | 0.0 |  | Reading at t = 0 (first settled sample) | 30.14857 | kg
20 | 29.78609 | 508175.5 | 0.010 | 32.37 | 0.0 |  | Reading at 30 min | 28.49217 | kg | last sample at or before 1800 s
30 | 29.66987 | 506182.9 | 0.010 | 32.36 | 0.0 |  | Reading at end | 28.43735 | kg
40 | 29.58666 | 504756.3 | 0.011 | 32.34 | 0.0 |  | Creep over 30 min | -1.65640 | kg | feeds T13 u_drift and Summary
50 | 29.52340 | 503671.7 | 0.009 | 32.32 | 0.0 |  | Creep over 30 min (%FS) | -1.840 | %FS
60 | 29.47142 | 502780.5 | 0.011 | 32.32 | 0.0 |  | Total excursion | 1.71274 | kg
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
2060 | 28.45443 | 485344.8 | 0.011 | 32.67 | 0.0
2070 | 28.44303 | 485149.3 | 0.009 | 32.67 | 0.0
2080 | 28.44172 | 485126.8 | 0.010 | 32.68 | 0.0
2090 | 28.43583 | 485025.9 | 0.009 | 32.68 | 0.0
2100 | 28.43735 | 485051.9 | 0.009 | 32.67 | 0.0
^ LAST PASTE ROW (1012). Nothing below this is read.

Sheet: T9_Step_Response_10_20
T9 — STEP RESPONSE
Harness menu 9 -> paste at A13 (one step per sheet, up to 1600 rows)
WHAT IT SHOWS: force, PWM and current every 20 ms through a commanded step, for rise time, overshoot and settling.
Rise time is 10 % to 90 % of the commanded change. Settling time is to ENTRY into the deadband after which the
force stays inside it, the same criterion the harness uses everywhere. Works for steps up and down.
One step per sheet: copy the sheet to keep several. Plot force against time for the paper.
KEY: GREEN = paste from the serial monitor | ORANGE = carry forward from the load-cell workbook | YELLOW, blue text = type by hand | GREY = helper, do not type | white = calculated
20 | 40 | 840 | 27.3361 | 92 | 3.144 | <- example of a pasted row (not used)
From (kg) | To (kg) | t (ms) | Force (kg) | PWM | Current (A) | t past 10 % (helper) | t past 90 % (helper) | t outside band (helper) | SUMMARY | Value | Unit
10.00 | 20.00 | 20 | 10.0817 | 6 | -0.021 |  |  | 20 | Step from | 10.00 | kg
10.00 | 20.00 | 40 | 10.0811 | 12 | -0.008 |  |  | 40 | Step to | 20.00 | kg
10.00 | 20.00 | 60 | 10.0826 | 18 | 0.028 |  |  | 60 | Step size | 10.00 | kg
10.00 | 20.00 | 80 | 10.0820 | 24 | 0.088 |  |  | 80 | t at 10 % of the change | 200 | ms
10.00 | 20.00 | 100 | 10.0833 | 30 | 0.162 |  |  | 100 | t at 90 % of the change | 360 | ms
10.00 | 20.00 | 120 | 10.0967 | 36 | 0.225 |  |  | 120 | Rise time 10-90 % | 0.160 | s
10.00 | 20.00 | 140 | 10.1299 | 42 | 0.295 |  |  | 140 | Peak force in the step direction | 20.5194 | kg
10.00 | 20.00 | 160 | 10.2477 | 48 | 0.297 |  |  | 160 | Overshoot | 5.19 | %
10.00 | 20.00 | 180 | 10.6257 | 54 | 0.367 |  |  | 180 | Settling time (entry, stays in band) | 5.920 | s
10.00 | 20.00 | 200 | 11.2433 | 60 | 0.361 | 200 |  | 200 | Final error (mean of last 25 samples) | 0.0787 | kg
10.00 | 20.00 | 220 | 12.0795 | 63 | 0.413 | 220 |  | 220 | Peak |motor current| | 0.485 | A
10.00 | 20.00 | 240 | 13.0888 | 59 | 0.431 | 240 |  | 240
10.00 | 20.00 | 260 | 14.1856 | 56 | 0.411 | 260 |  | 260
10.00 | 20.00 | 280 | 15.3268 | 52 | 0.485 | 280 |  | 280
10.00 | 20.00 | 300 | 16.4536 | 49 | 0.472 | 300 |  | 300
10.00 | 20.00 | 320 | 17.4820 | 47 | 0.441 | 320 |  | 320
10.00 | 20.00 | 340 | 18.3682 | 0 | 0.415 | 340 |  | 340
10.00 | 20.00 | 360 | 19.0475 | 0 | 0.299 | 360 | 360 | 360
10.00 | 20.00 | 380 | 19.3039 | 0 | 0.209 | 380 | 380 | 380
10.00 | 20.00 | 400 | 19.3714 | 0 | 0.128 | 400 | 400 | 400
10.00 | 20.00 | 420 | 19.3645 | 45 | 0.101 | 420 | 420 | 420
10.00 | 20.00 | 440 | 19.3645 | 45 | 0.258 | 440 | 440 | 440
10.00 | 20.00 | 460 | 19.5008 | 0 | 0.337 | 460 | 460 | 460
10.00 | 20.00 | 480 | 19.8167 | 0 | 0.239 | 480 | 480
10.00 | 20.00 | 500 | 19.9884 | 0 | 0.170 | 500 | 500
10.00 | 20.00 | 520 | 20.0347 | 0 | 0.129 | 520 | 520
10.00 | 20.00 | 540 | 20.0304 | 0 | 0.100 | 540 | 540
10.00 | 20.00 | 560 | 20.0084 | 0 | 0.067 | 560 | 560
10.00 | 20.00 | 580 | 19.9799 | 0 | 0.038 | 580 | 580
10.00 | 20.00 | 600 | 19.9500 | 0 | 0.041 | 600 | 600
10.00 | 20.00 | 620 | 19.9195 | 46 | 0.032 | 620 | 620
10.00 | 20.00 | 640 | 19.9360 | 0 | 0.197 | 640 | 640
10.00 | 20.00 | 660 | 20.0750 | 0 | 0.133 | 660 | 660
10.00 | 20.00 | 680 | 20.1321 | 0 | 0.088 | 680 | 680
10.00 | 20.00 | 700 | 20.1423 | 0 | 0.057 | 700 | 700
10.00 | 20.00 | 720 | 20.1337 | 0 | 0.050 | 720 | 720
10.00 | 20.00 | 740 | 20.1157 | 0 | 0.033 | 740 | 740
10.00 | 20.00 | 760 | 20.0947 | 0 | 0.025 | 760 | 760
10.00 | 20.00 | 780 | 20.0738 | 0 | 0.017 | 780 | 780
10.00 | 20.00 | 800 | 20.0523 | 0 | 0.021 | 800 | 800
10.00 | 20.00 | 820 | 20.0343 | 0 | 0.009 | 820 | 820
10.00 | 20.00 | 840 | 20.0188 | 0 | 0.017 | 840 | 840
10.00 | 20.00 | 860 | 20.0014 | 0 | 0.007 | 860 | 860
10.00 | 20.00 | 880 | 19.9851 | 0 | 0.010 | 880 | 880
10.00 | 20.00 | 900 | 19.9702 | 0 | 0.004 | 900 | 900
10.00 | 20.00 | 920 | 19.9572 | 0 | 0.013 | 920 | 920
10.00 | 20.00 | 940 | 19.9453 | 46 | 0.008 | 940 | 940
10.00 | 20.00 | 960 | 19.9612 | 0 | 0.181 | 960 | 960
10.00 | 20.00 | 980 | 20.0719 | 0 | 0.155 | 980 | 980
10.00 | 20.00 | 1000 | 20.1087 | 0 | 0.069 | 1000 | 1000
10.00 | 20.00 | 1020 | 20.1138 | 0 | 0.058 | 1020 | 1020
10.00 | 20.00 | 1040 | 20.1080 | 0 | 0.063 | 1040 | 1040
10.00 | 20.00 | 1060 | 20.0955 | 0 | 0.037 | 1060 | 1060
10.00 | 20.00 | 1080 | 20.0792 | 0 | 0.026 | 1080 | 1080
10.00 | 20.00 | 1100 | 20.0635 | 0 | 0.011 | 1100 | 1100
10.00 | 20.00 | 1120 | 20.0482 | 0 | -0.005 | 1120 | 1120
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
10.00 | 20.00 | 13560 | 19.9948 | 0 | 0.020 | 13560 | 13560
10.00 | 20.00 | 13580 | 19.9937 | 0 | 0.026 | 13580 | 13580
10.00 | 20.00 | 13600 | 19.9943 | 0 | 0.013 | 13600 | 13600
10.00 | 20.00 | 13620 | 19.9950 | 0 | 0.013 | 13620 | 13620

Sheet: T13_Uncertainty
T13 — MEASUREMENT UNCERTAINTY BUDGET
Calculated — no harness test. Fill in last.
Follows ISO 7500-1 Annex C. Rectangular contributions divide by root 3; resolution by 2 root 3.
Combined standard uncertainty = root sum of squares (contributions assumed independent); expanded U uses k = 2.
BUDGET 1 is for the force the rig REPORTS. BUDGET 2 adds command error, direction dependence, deadband and
seating for the force the rig GENERATES, which is what a user of a force-controlled rig relies on.
KEY: GREEN = paste from the serial monitor | ORANGE = carry forward from the load-cell workbook | YELLOW, blue text = type by hand | GREY = helper, do not type | white = calculated
BUDGET 1 — INDICATED FORCE (relative, %)
 |  | Force level (kg) -> | 20 | 40 | 60
Symbol | Contribution | Distribution |  |  |  | Source
u_rep | Repeatability of indication | Rect / 2 root 3 | 0.1213 | 0.1213 | 0.1213 | LC_Reference b (UTM rounds)
u_res | Resolution | Rect / 2 root 3 | 0.0144 | 0.0072 | 0.0048 | T1 declared resolution
u_std | Reference standard (UTM) | Normal, k = 2 |  |  |  | Setup B25
u_hys | Reversibility (hysteresis) | Rect / root 3 | 0.0821 | 0.0821 | 0.0821 | LC_Reference v
u_drift | Zero drift and creep | Rect / root 3 | 0.0809 | 0.0404 | 0.0270 | T6 zero drift (1 h) or T7 loop-on creep; loop-off relaxation is a real force change, excluded
u_fit | Calibration model residual | Normal, k = 1 | 0.5489 | 0.2745 | 0.1830 | LC_Reference residual SD
u_T | Temperature over the session | Rect / root 3 |  |  |  | TYPE: from a temperature coefficient and Setup B19
u_c | Combined standard uncertainty |  | 0.5740 | 0.3138 | 0.2360 | blank until LC_Reference, T1 and the fit residual are in
U | Expanded uncertainty, k = 2 |  | 1.1481 | 0.6276 | 0.4720
BUDGET 2 — GENERATED FORCE (relative, %, at the middle level E13)
Symbol | Contribution |  | Value (%) |  |  | Source
u_ind | Indicated force |  | 0.3138 |  |  | Budget 1, middle level
u_cmd | Command-to-achieved error |  | 0.3936 |  |  | T2 worst |error|, rescaled to E13
u_dir | Approach-direction dependence |  | 0.3802 |  |  | T5 worst |delta
u_db | Controller deadband |  | 0.5774 |  |  | Setup B23
u_seat | Seating reproducibility |  | 0.2453 |  |  | T4 Gauge R&R SD
u_c | Combined standard uncertainty |  | 0.8896
U | Expanded uncertainty, k = 2 |  | 1.7793
ASSUMPTION: contributions are independent. u_cmd already contains part of the deadband effect, so Budget 2 is conservative. Say so in the paper.

Sheet: Summary
SUMMARY — transfer into the paper
Calculated — nothing to paste. A blank value means its sheet is not finished.
KEY: GREEN = paste from the serial monitor | ORANGE = carry forward from the load-cell workbook | YELLOW, blue text = type by hand | GREY = helper, do not type | white = calculated
Characteristic | Value | Unit | Source
RANGE AND CALIBRATION
Working range upper limit F_N | 90.0 | kg | Setup
Load-cell slope k | 0.0000583277 | kg/count | LC_Reference
Load-cell intercept c | 0.1454 | kg | LC_Reference
Calibration fit R squared | 0.999989 | - | LC_Reference
Residual SD of calibration fit | 0.1098 | kg | LC_Reference
Flashed constants match the UTM fit? | matches LC_Reference |  | Setup
MEASURING SYSTEM (ISO 7500-1)
Declared resolution r | 0.0100 | kg | T1
Noise SD, idle, motor power off | 0.00151 | kg | T1
Noise SD, idle, motor power on | 0.00154 | kg | T1
Relative indication error q, worst | 0.738 | % | LC_Reference
Relative repeatability b, worst | 0.420 | % | LC_Reference
Relative reversibility v, worst | 0.142 | % | LC_Reference
Relative zero error f0 | 0.025 | % | LC_Reference
FORCE GENERATION
Command-to-achieved error, worst | 0.303 | %FS | T2
Command-to-achieved error, RMS | 0.130 | %FS | T2
Settling time, worst (static approach) | 82.08 | s | T2
Short-term repeatability, worst CV | 0.348 | % | T3
Short-term repeatability, worst SD | 0.1742 | kg | T3
Gauge R&R standard deviation | 0.0981 | kg | T4
Gauge R&R, % of total variation | 0.33 | % | T4
Direction dependence, worst | 0.2634 | kg | T5
STABILITY AND DYNAMICS
Warm-up period | 28.3 | min | T6
Zero drift after warm-up | 0.00305 | kg/h | T6
Creep over 30 min, loop on | -0.0280 | kg | T7
Creep over 30 min, loop off | -1.6564 | kg | T8
Step rise time 10-90 % | 0.160 | s | T9
Step overshoot | 5.19 | % | T9
Step settling time | 5.920 | s | T9
Practical cyclic envelope (mean T >= 0.95) | 0.250 | Hz | T10
DRIVE AND THERMAL
Current per kg of thrust | 0.0141 | A/kg | T11
Running current, free air (first PWM level) | 0.246 | A | T11
Highest motor current observed | 1.46 | A | T11
Driver temperature rise, 60 min unloaded | 5.7 | C | T6
Driver temperature rise across cycling | 0.1 | C | T10
SAFETY AND UNCERTAINTY
Protective functions verified | 10 | of 11 | T12
Protective functions failed | 1 |  | T12
Expanded uncertainty, indicated force (k = 2, at E13) | 0.628 | % | T13
Expanded uncertainty, generated force (k = 2) | 1.779 | % | T13
Assigned ISO 7500-1 class (your judgement from LC_Reference and T1) |  |  | type
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
