sachinthaLUT/RIGOR/hardware/electronics/kicad/Force_Rig_PCB_V2/3D Model/E-STOP AB6E-3BV02PTRM.stp

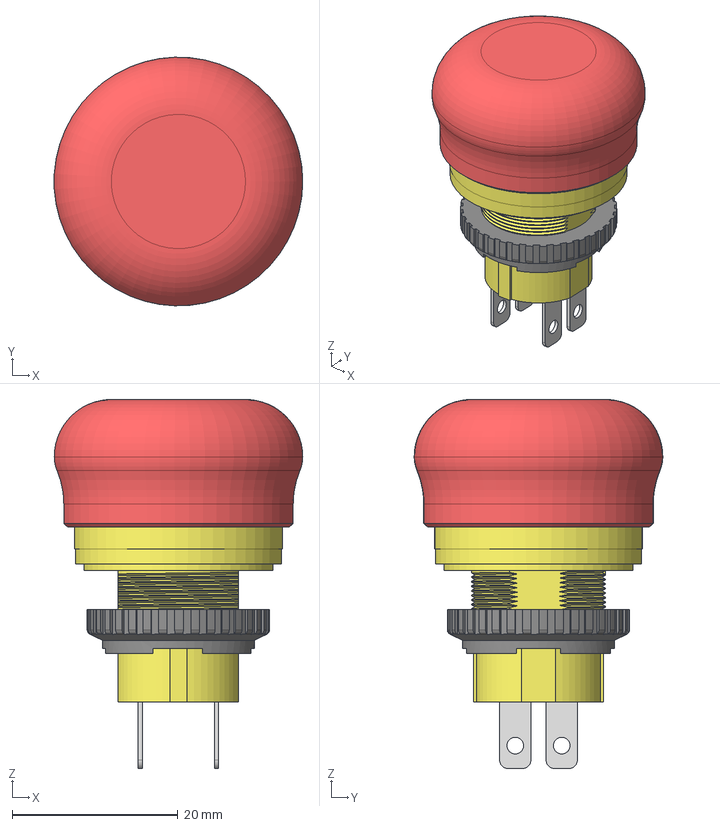
[picture p22: CAD file, 2026-11-10]
hardware/electronics/kicad/Force_Rig_PCB_V2/3D Model/E-STOP AB6E-3BV02PTRM.stp
30.0 x 30.0 x 44.5 mm
