sachinthaLUT/RIGOR/hardware/mechanical/3mf/Enclosure Lid.3MF

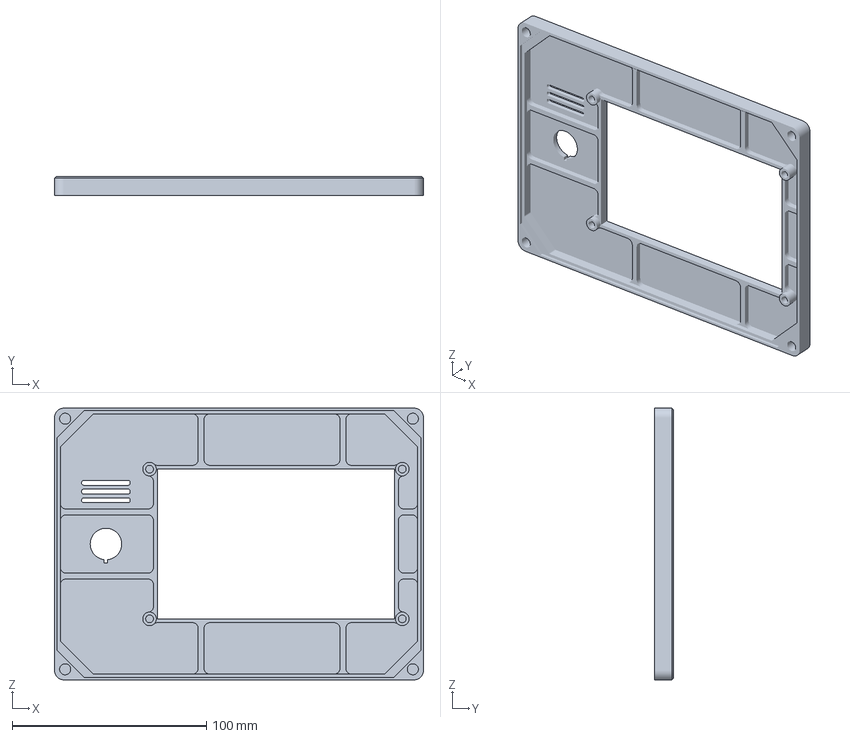
[picture p23: CAD file, 2026-11-10]
hardware/mechanical/3mf/Enclosure Lid.3MF
190.0 x 10.0 x 140.0 mm
