sachinthaLUT/RIGOR/hardware/electronics/kicad/Force_Rig_PCB_V2/3D Model/Enclosure.SLDPRT

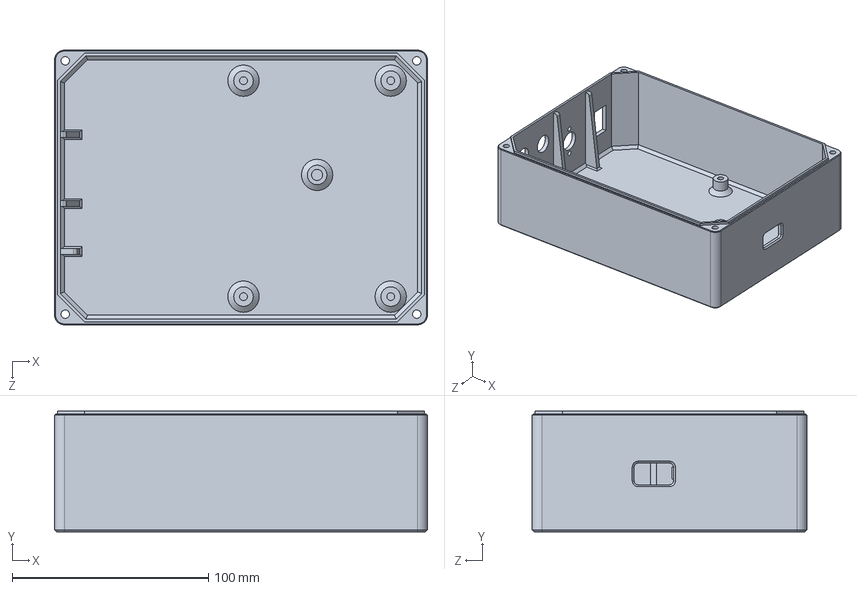
[picture p24: CAD file, 2026-11-10]
hardware/electronics/kicad/Force_Rig_PCB_V2/3D Model/Enclosure.SLDPRT
190.0 x 61.5 x 140.0 mm
