sachinthaLUT/RIGOR/hardware/electronics/kicad/Force_Rig_PCB_V2/3D Model/PCB.step

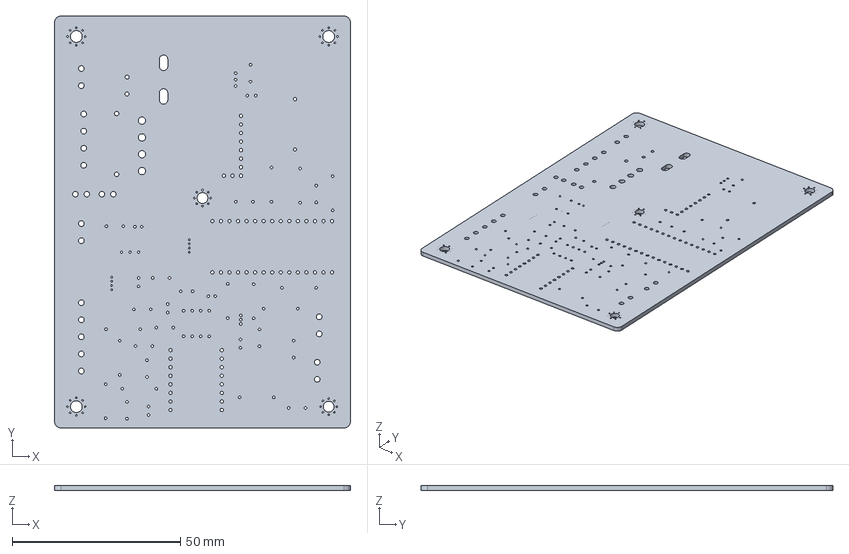
[picture p25: CAD file, 2026-11-10]
hardware/electronics/kicad/Force_Rig_PCB_V2/3D Model/PCB.step
88.0 x 122.5 x 1.51 mm
