sachinthaLUT/RIGOR/hardware/electronics/kicad/Force_Rig_PCB_V2/3D Model/Assembly.SLDASM

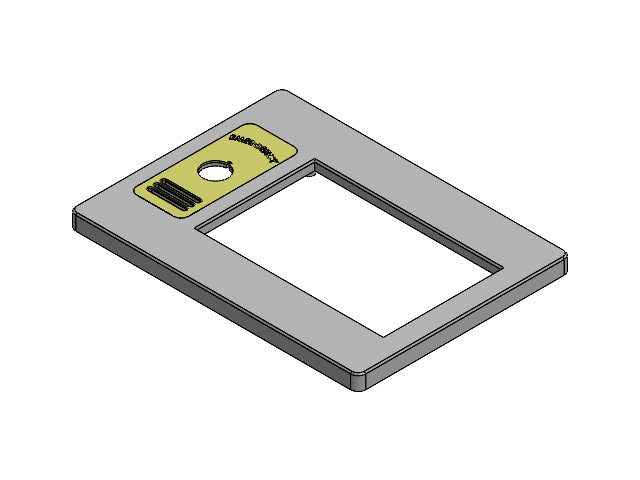
[picture p26: CAD file, 2026-11-10]
hardware/electronics/kicad/Force_Rig_PCB_V2/3D Model/Assembly.SLDASM
Enclosure lid^Assembly
Part2^Assembly
