sachinthaLUT/RIGOR/(list of files, cad)

Other CAD files:
hardware/mechanical/3mf/Enclosure Body.3MF
