sachinthaLUT/RIGOR/hardware/mechanical/step/README.md

# STEP exports

STEP AP214 exports of the rig assembly (`Portable Rig.step`) and of each custom part, for use without SolidWorks. In SolidWorks: File → Save As → STEP AP214.
