sachinthaLUT/RIGOR/calibration/Load_Cell_Calibration_Data.xlsx

Sheet: README
Load Cell Calibration Workbook
100 kg load cell - ADS1220 - Arduino Nano ESP32 - UTM compressive force
How to use this workbook
1. Run the Arduino sketch, send 'C' for Calibrate mode.
2. UP sweep: load 0->100 kg. At each point press M (loaded), then R after lifting (resting).
3. DOWN sweep: unload 100->0 kg. Again press M at each held load, R after lifting.
4. For each Applied capture, record BOTH the actual UTM force (N) AND the raw ADC counts.
5. Removed = raw counts only (return-to-zero check).
6. Repeat the full Up+Down cycle for all 3 rounds.
IMPORTANT - record ACTUAL applied force
- The nominal column (0,10,20...) is only a target guide (grey).
- Commanding 50 N but the UTM settling at 49.8 N is fine - just log 49.8 N.
- The regression fits true force vs counts, so always enter what the UTM actually applied.
- Read the UTM force and the load-cell counts at the SAME settled moment.
Why separate Up and Down sweeps?
- A load cell reads slightly differently at the same force from below vs above (hysteresis).
- Recording both directions lets you measure that gap.
Sheets
- Calibration Data -> enter actual force (N) + raw counts here.
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
