sachinthaLUT/RIGOR/firmware/hmi/TouchScreenESP32Firmware/mockups/03_Static_Testing.png

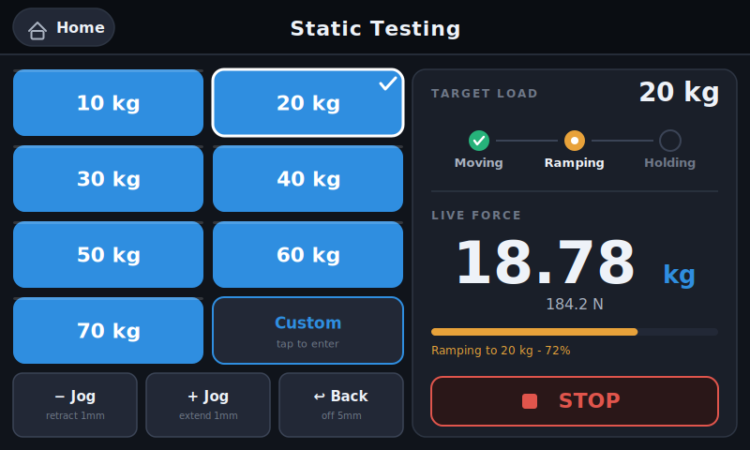
firmware/hmi/TouchScreenESP32Firmware/mockups/03_Static_Testing.png
