sachinthaLUT/RIGOR/firmware/hmi/TouchScreenESP32Firmware/mockups/05_Calibration.png

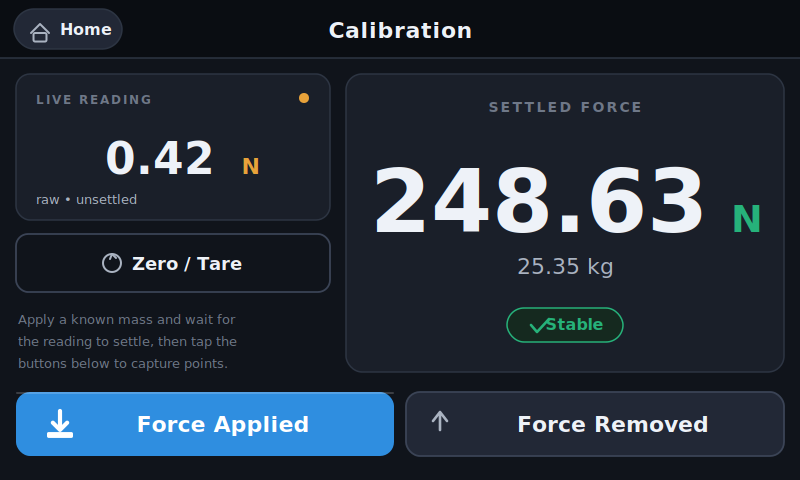
firmware/hmi/TouchScreenESP32Firmware/mockups/05_Calibration.png
