sachinthaLUT/RIGOR/hardware/mechanical/drawings/Actuator bracket 2.pdf

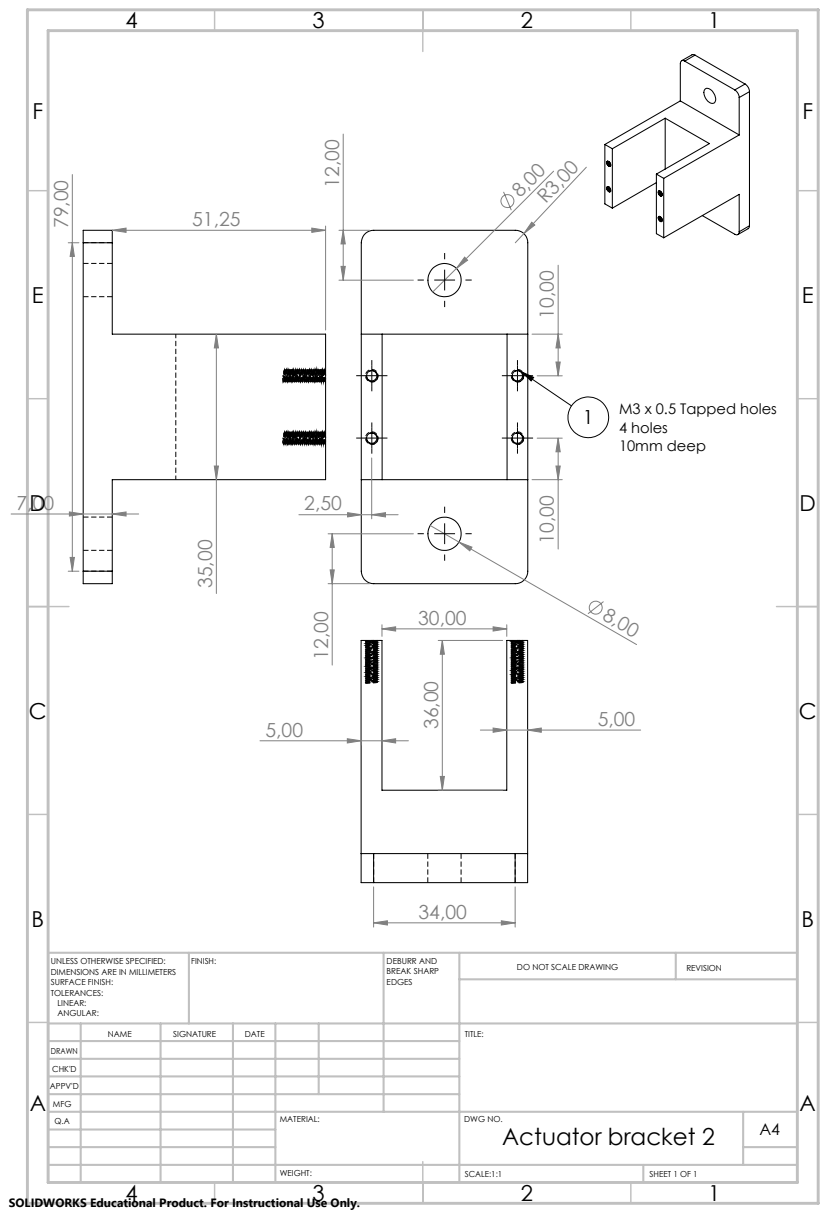
[picture p31: page 1]
M3 x 0.5 Tapped holes 4 holes 10mm deep; FINISH:; DEBURR AND; BREAK SHARP; DO NOT SCALE DRAWING; REVISION; SCALE:1:1; SHEET 1 OF 1

UNLESS OTHERWISE SPECIFIED:
DIMENSIONS ARE IN MILLIMETERS
SURFACE FINISH:
TOLERANCES:
LINEAR:
ANGULAR:

NAME | SIGNATURE | DATE | | | | TITLE:

DRAWN
CHK'D
APPV'D
MFG
Q.A | | | | MATERIAL: | DWG NO. Actuator bracket 2 | A4

SOLIDWORKS Educational Product. For Instructional Use Only.
