sachinthaLUT/RIGOR/hardware/mechanical/drawings/BracketLid.pdf

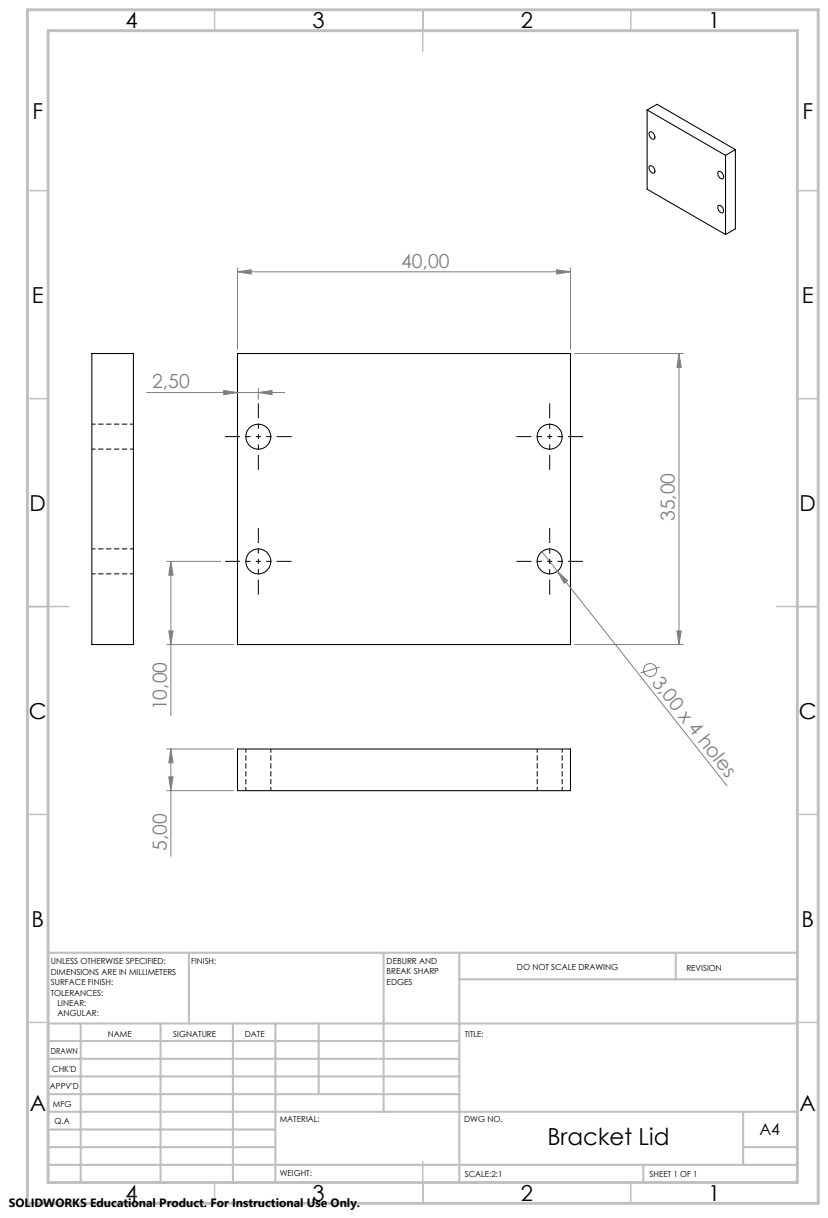
[picture p32: page 1]
3,00 x 4 holes; FINISH:; DEBURR AND; BREAK SHARP; DO NOT SCALE DRAWING; REVISION; SCALE:2:1; SHEET 1 OF 1

UNLESS OTHERWISE SPECIFIED:
DIMENSIONS ARE IN MILLIMETERS
SURFACE FINISH:
TOLERANCES:
LINEAR:
ANGULAR:

NAME | SIGNATURE | DATE | | | | TITLE:

DRAWN
CHK'D
APPV'D
MFG
Q.A | | | | MATERIAL: | DWG NO. Bracket Lid | A4

SOLIDWORKS Educational Product. For Instructional Use Only.
