sachinthaLUT/RIGOR/hardware/mechanical/drawings/LoadCellActuatorBracket.pdf

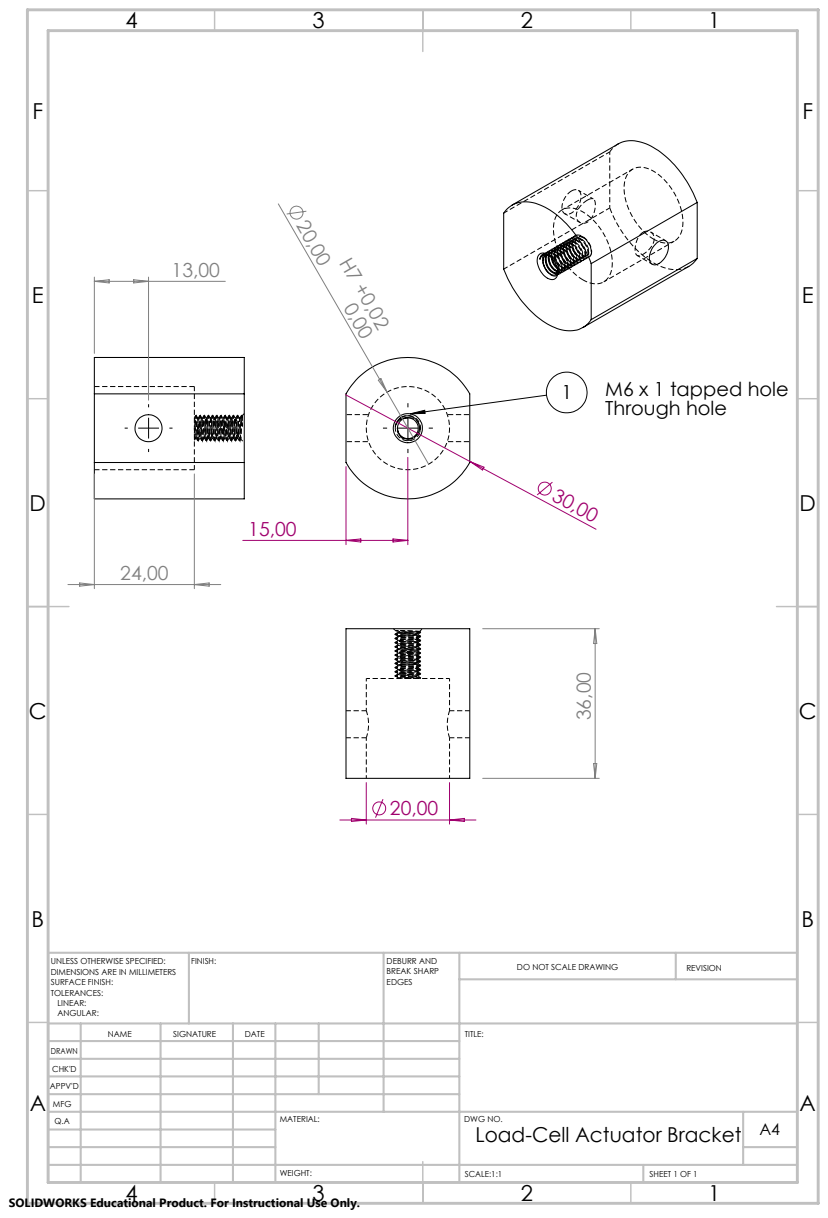
[picture p33: page 1]
M6 x 1 tapped hole; Through hole; FINISH:; DEBURR AND; BREAK SHARP; DO NOT SCALE DRAWING; REVISION; SCALE:1:1; SHEET 1 OF 1

UNLESS OTHERWISE SPECIFIED:
DIMENSIONS ARE IN MILLIMETERS
SURFACE FINISH:
TOLERANCES:
LINEAR:
ANGULAR:

NAME | SIGNATURE | DATE | | | | TITLE:

DRAWN
CHK'D
APPV'D
MFG
Q.A | | | | MATERIAL: | DWG NO. Load-Cell Actuator Bracket | A4

SOLIDWORKS Educational Product. For Instructional Use Only.
