sachinthaLUT/RIGOR/firmware/hmi/TouchScreenESP32Firmware/esp_panel_board_custom_conf.h

/*
 * SPDX-FileCopyrightText: 2023-2025 Espressif Systems (Shanghai) CO LTD
 *
 * SPDX-License-Identifier: Apache-2.0
 */
/**
 * @file   esp_panel_board_custom_conf.h
 * @brief  Configuration file for custom ESP development boards
 * @author
 * @link
 *
 * This file contains all the configurations needed for a custom board using ESP Panel.
 * Users can modify these configurations according to their hardware design.
 */

#pragma once

// *INDENT-OFF*

/**
 * @brief Flag to enable custom board configuration (0/1)
 *
 * Set to `1` to enable custom board configuration, `0` to disable
 */
#define ESP_PANEL_BOARD_DEFAULT_USE_CUSTOM  (1)

#if ESP_PANEL_BOARD_DEFAULT_USE_CUSTOM
////////////////////////////////////////////////////////////////////////////////////////////////////////////////////////
///////////////////////// Please update the following macros to configure general parameters ///////////////////////////
////////////////////////////////////////////////////////////////////////////////////////////////////////////////////////
/**
 * @brief Board name (format: "Manufacturer:Model")
 */
#define ESP_PANEL_BOARD_NAME                "Sunton:ESP32-8048S050"

/**
 * @brief Panel resolution configuration in pixels
 */
#define ESP_PANEL_BOARD_WIDTH               (800)   // Panel width (horizontal, in pixels)
#define ESP_PANEL_BOARD_HEIGHT              (480)   // Panel height (vertical, in pixels)

////////////////////////////////////////////////////////////////////////////////////////////////////////////////////////
//////////////////////////// Please update the following macros to configure the LCD panel /////////////////////////////
////////////////////////////////////////////////////////////////////////////////////////////////////////////////////////
/**
 * @brief LCD panel configuration flag (0/1)
 *
 * Set to `1` to enable LCD panel support, `0` to disable
 */
#define ESP_PANEL_BOARD_USE_LCD             (1)

#if ESP_PANEL_BOARD_USE_LCD
/**
 * @brief LCD controller selection
 *
 * Supported controllers:
 * - `AXS15231B`
 * - `EK9716B`, `EK79007`
 * - `GC9A01`, `GC9B71`, `GC9503`
 * - `HX8399`
 * - `ILI9341`, `ILI9881C`
 * - `JD9165`, `JD9365`
 * - `NV3022B`
 * - `SH8601`
 * - `SPD2010`
 * - `ST7262`, `ST7701`, `ST7703`, `ST7789`, `ST7796`, `ST77903`, `ST77916`, `ST77922`
 */
#define ESP_PANEL_BOARD_LCD_CONTROLLER      ST7262

/**
 * @brief LCD bus type selection
 *
 * Supported bus types:
 * - `ESP_PANEL_BUS_TYPE_SPI`
 * - `ESP_PANEL_BUS_TYPE_QSPI`
 * - `ESP_PANEL_BUS_TYPE_RGB` (ESP32-S3 only)
 * - `ESP_PANEL_BUS_TYPE_MIPI_DSI` (ESP32-P4 only)
 */
#define ESP_PANEL_BOARD_LCD_BUS_TYPE        (ESP_PANEL_BUS_TYPE_RGB)

#if (ESP_PANEL_BOARD_LCD_BUS_TYPE == ESP_PANEL_BUS_TYPE_SPI) || \
    (ESP_PANEL_BOARD_LCD_BUS_TYPE == ESP_PANEL_BUS_TYPE_QSPI)
/**
 * If set to 1, the bus will skip to initialize the corresponding host. Users need to initialize the host in advance.
 *
 * For drivers which created by this library, even if they use the same host, the host will be initialized only once.
 * So it is not necessary to set the macro to `1`. For other drivers (like `Wire`), please set the macro to `1`
 * ensure that the host is initialized only once.
 */
#define ESP_PANEL_BOARD_LCD_BUS_SKIP_INIT_HOST      (0)     // 0/1. Typically set to 0
#endif

/**
 * @brief LCD bus parameters configuration
 *
 * Configure parameters based on the selected bus type. Parameters for other bus types will be ignored.
 * For detailed parameter explanations, see:
 * https://docs.espressif.com/projects/esp-idf/en/v5.3.1/esp32s3/api-reference/peripherals/lcd/index.html
 * https://docs.espressif.com/projects/esp-iot-solution/en/latest/display/lcd/index.html
 */
#if ESP_PANEL_BOARD_LCD_BUS_TYPE == ESP_PANEL_BUS_TYPE_SPI

    /**
     * @brief SPI bus
     */
    /* For general */
    #define ESP_PANEL_BOARD_LCD_SPI_HOST_ID         (1)     // Typically set to 1
#if !ESP_PANEL_BOARD_LCD_BUS_SKIP_INIT_HOST
    /* For host */
    #define ESP_PANEL_BOARD_LCD_SPI_IO_SCK          (7)
    #define ESP_PANEL_BOARD_LCD_SPI_IO_MOSI         (6)
    #define ESP_PANEL_BOARD_LCD_SPI_IO_MISO         (-1)    // -1 if not used
#endif // ESP_PANEL_BOARD_LCD_BUS_SKIP_INIT_HOST
    /* For panel */
    #define ESP_PANEL_BOARD_LCD_SPI_IO_CS           (5)     // -1 if not used
    #define ESP_PANEL_BOARD_LCD_SPI_IO_DC           (4)
    #define ESP_PANEL_BOARD_LCD_SPI_MODE            (0)     // 0-3. Typically set to 0
    #define ESP_PANEL_BOARD_LCD_SPI_CLK_HZ          (40 * 1000 * 1000)
                                                            // Should be an integer divisor of 80M, typically set to 40M
    #define ESP_PANEL_BOARD_LCD_SPI_CMD_BITS        (8)     // Typically set to 8
    #define ESP_PANEL_BOARD_LCD_SPI_PARAM_BITS      (8)     // Typically set to 8

#elif ESP_PANEL_BOARD_LCD_BUS_TYPE == ESP_PANEL_BUS_TYPE_QSPI

    /**
     * @brief QSPI bus
     */
    /* For general */
    #define ESP_PANEL_BOARD_LCD_QSPI_HOST_ID        (1)     // Typically set to 1
#if !ESP_PANEL_BOARD_LCD_BUS_SKIP_INIT_HOST
    /* For host */
    #define ESP_PANEL_BOARD_LCD_QSPI_IO_SCK         (9)
    #define ESP_PANEL_BOARD_LCD_QSPI_IO_DATA0       (10)
    #define ESP_PANEL_BOARD_LCD_QSPI_IO_DATA1       (11)
    #define ESP_PANEL_BOARD_LCD_QSPI_IO_DATA2       (12)
    #define ESP_PANEL_BOARD_LCD_QSPI_IO_DATA3       (13)
#endif // ESP_PANEL_BOARD_LCD_BUS_SKIP_INIT_HOST
    /* For panel */
    #define ESP_PANEL_BOARD_LCD_QSPI_IO_CS          (5)     // -1 if not used
    #define ESP_PANEL_BOARD_LCD_QSPI_MODE           (0)     // 0-3, typically set to 0
    #define ESP_PANEL_BOARD_LCD_QSPI_CLK_HZ         (40 * 1000 * 1000)
                                                            // Should be an integer divisor of 80M, typically set to 40M
    #define ESP_PANEL_BOARD_LCD_QSPI_CMD_BITS       (32)    // Typically set to 32
    #define ESP_PANEL_BOARD_LCD_QSPI_PARAM_BITS     (8)     // Typically set to 8

#elif ESP_PANEL_BOARD_LCD_BUS_TYPE == ESP_PANEL_BUS_TYPE_RGB

    /**
     * @brief RGB bus
     */
    /**
     * Set to 0 if using simple "RGB" interface which does not contain "3-wire SPI" interface.
     */
    #define ESP_PANEL_BOARD_LCD_RGB_USE_CONTROL_PANEL       (0) // 0/1. Typically set to 1

#if ESP_PANEL_BOARD_LCD_RGB_USE_CONTROL_PANEL
    /* For control panel (3wire-SPI) */
    #define ESP_PANEL_BOARD_LCD_RGB_SPI_IO_CS               (0)
    #define ESP_PANEL_BOARD_LCD_RGB_SPI_IO_SCK              (1)
    #define ESP_PANEL_BOARD_LCD_RGB_SPI_IO_SDA              (2)
    #define ESP_PANEL_BOARD_LCD_RGB_SPI_CS_USE_EXPNADER     (0) // Set to 1 if the signal is controlled by an IO expander
    #define ESP_PANEL_BOARD_LCD_RGB_SPI_SCL_USE_EXPNADER    (0) // Set to 1 if the signal is controlled by an IO expander
    #define ESP_PANEL_BOARD_LCD_RGB_SPI_SDA_USE_EXPNADER    (0) // Set to 1 if the signal is controlled by an IO expander
    #define ESP_PANEL_BOARD_LCD_RGB_SPI_MODE                (0) // 0-3, typically set to 0
    #define ESP_PANEL_BOARD_LCD_RGB_SPI_CMD_BYTES           (1) // Typically set to 1
    #define ESP_PANEL_BOARD_LCD_RGB_SPI_PARAM_BYTES         (1) // Typically set to 1
    #define ESP_PANEL_BOARD_LCD_RGB_SPI_USE_DC_BIT          (1) // 0/1. Typically set to 1
#endif // ESP_PANEL_BOARD_LCD_RGB_USE_CONTROL_PANEL
    /* For refresh panel (RGB) */
    #define ESP_PANEL_BOARD_LCD_RGB_CLK_HZ          (16 * 1000 * 1000)
                                                            // To increase the upper limit of the PCLK, see: https://docs.espressif.com/projects/esp-faq/en/latest/software-framework/peripherals/lcd.html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
    #define ESP_PANEL_BOARD_LCD_RGB_HPW             (4)
    #define ESP_PANEL_BOARD_LCD_RGB_HBP             (8)
    #define ESP_PANEL_BOARD_LCD_RGB_HFP             (8)
    #define ESP_PANEL_BOARD_LCD_RGB_VPW             (4)
    #define ESP_PANEL_BOARD_LCD_RGB_VBP             (8)
    #define ESP_PANEL_BOARD_LCD_RGB_VFP             (8)
    #define ESP_PANEL_BOARD_LCD_RGB_PCLK_ACTIVE_NEG (1)     // 0: rising edge, 1: falling edge. Typically set to 0
                                                                                        // The following sheet shows the valid combinations of
                                                                                        // data width and pixel bits:
                                                                                        // ┏---------------------------------┳- -------------------------------┓
    #define ESP_PANEL_BOARD_LCD_RGB_DATA_WIDTH      (16)                                // |                16               |               8                 |
    #define ESP_PANEL_BOARD_LCD_RGB_PIXEL_BITS      (ESP_PANEL_LCD_COLOR_BITS_RGB565)   // | ESP_PANEL_LCD_COLOR_BITS_RGB565 | ESP_PANEL_LCD_COLOR_BITS_RGB888 |
                                                                                        // ┗---------------------------------┻---------------------------------┛
                                                            // To understand color format of RGB LCD, see: https://docs.espressif.com/projects/esp-iot-solution/en/latest/display/lcd/rgb_lcd.html#color-formats
    #define ESP_PANEL_BOARD_LCD_RGB_BOUNCE_BUF_SIZE (ESP_PANEL_BOARD_WIDTH * 10)
                                                            // Bounce buffer size in bytes. It is used to avoid screen drift
                                                            // for ESP32-S3. Typically set to `ESP_PANEL_BOARD_WIDTH * 10`
                                                            // The size should satisfy `size * N = LCD_width * LCD_height`,
                                                            // where N is an even number.
                                                            // For more details, see: https://github.com/esp-arduino-libs/ESP32_Display_Panel/blob/master/docs/FAQ.md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
    #define ESP_PANEL_BOARD_LCD_RGB_IO_HSYNC        (39)
    #define ESP_PANEL_BOARD_LCD_RGB_IO_VSYNC        (41)
    #define ESP_PANEL_BOARD_LCD_RGB_IO_DE           (40)    // -1 if not used
    #define ESP_PANEL_BOARD_LCD_RGB_IO_PCLK         (42)
    #define ESP_PANEL_BOARD_LCD_RGB_IO_DISP         (-1)    // -1 if not used. Typically set to -1

                                                            // The following sheet shows the mapping of ESP GPIOs to
                                                            // LCD data pins with different data width and color format:
                                                            // ┏------┳- ------------┳--------------------------┓
                                                            // | ESP: | 8-bit RGB888 |      16-bit RGB565       |
                                                            // |------|--------------|--------------------------|
                                                            // | LCD: |    RGB888    | RGB565 | RGB666 | RGB888 |
                                                            // ┗------|--------------|--------|--------|--------|
    #define ESP_PANEL_BOARD_LCD_RGB_IO_DATA0        (8)    //        |      D0      |   B0   |  B0-1  |   B0-3 |
    #define ESP_PANEL_BOARD_LCD_RGB_IO_DATA1        (3)    //        |      D1      |   B1   |  B2    |   B4   |
    #define ESP_PANEL_BOARD_LCD_RGB_IO_DATA2        (46)    //        |      D2      |   B2   |  B3    |   B5   |
    #define ESP_PANEL_BOARD_LCD_RGB_IO_DATA3        (9)    //        |      D3      |   B3   |  B4    |   B6   |
    #define ESP_PANEL_BOARD_LCD_RGB_IO_DATA4        (1)    //        |      D4      |   B4   |  B5    |   B7   |
    #define ESP_PANEL_BOARD_LCD_RGB_IO_DATA5        (5)    //        |      D5      |   G0   |  G0    |   G0-2 |
    #define ESP_PANEL_BOARD_LCD_RGB_IO_DATA6        (6)    //        |      D6      |   G1   |  G1    |   G3   |
    #define ESP_PANEL_BOARD_LCD_RGB_IO_DATA7        (7)    //        |      D7      |   G2   |  G2    |   G4   |
#if ESP_PANEL_BOARD_LCD_RGB_DATA_WIDTH > 8                  //        ┗--------------┫--------|--------|--------|
    #define ESP_PANEL_BOARD_LCD_RGB_IO_DATA8        (15)    //                       |   G3   |  G3    |   G5   |
    #define ESP_PANEL_BOARD_LCD_RGB_IO_DATA9        (16)    //                       |   G4   |  G4    |   G6   |
    #define ESP_PANEL_BOARD_LCD_RGB_IO_DATA10       (4)    //                       |   G5   |  G5    |   G7   |
    #define ESP_PANEL_BOARD_LCD_RGB_IO_DATA11       (45)    //                       |   R0   |  R0-1  |   R0-3 |
    #define ESP_PANEL_BOARD_LCD_RGB_IO_DATA12       (48)    //                       |   R1   |  R2    |   R4   |
    #define ESP_PANEL_BOARD_LCD_RGB_IO_DATA13       (47)    //                       |   R2   |  R3    |   R5   |
    #define ESP_PANEL_BOARD_LCD_RGB_IO_DATA14       (21)     //                       |   R3   |  R4    |   R6   |
    #define ESP_PANEL_BOARD_LCD_RGB_IO_DATA15       (14)     //                       |   R4   |  R5    |   R7   |
                                                            //                       ┗--------┻--------┻--------┛
#endif // ESP_PANEL_BOARD_LCD_RGB_DATA_WIDTH

#elif ESP_PANEL_BOARD_LCD_BUS_TYPE == ESP_PANEL_BUS_TYPE_MIPI_DSI

    /**
     * @brief MIPI DSI bus
     */
    /* For host */
    #define ESP_PANEL_BOARD_LCD_MIPI_DSI_LANE_NUM           (2)     // ESP32-P4 supports 1 or 2 lanes
    #define ESP_PANEL_BOARD_LCD_MIPI_DSI_LANE_RATE_MBPS     (1000)  // Single lane bit rate, should check the LCD drive IC
                                                                    // datasheet for the supported lane rate. Different
                                                                    // color format (RGB565/RGB888) may have different
                                                                    // lane bit rate requirements.
                                                                    // ESP32-P4 supports max 1500Mbps
    /* For refresh panel (DPI) */
    #define ESP_PANEL_BOARD_LCD_MIPI_DPI_CLK_MHZ            (52)
    #define ESP_PANEL_BOARD_LCD_MIPI_DPI_PIXEL_BITS         (ESP_PANEL_LCD_COLOR_BITS_RGB565)
                                                                    // ESP_PANEL_LCD_COLOR_BITS_RGB565/RGB666/RGB888
    #define ESP_PANEL_BOARD_LCD_MIPI_DPI_HPW                (10)
    #define ESP_PANEL_BOARD_LCD_MIPI_DPI_HBP                (160)
    #define ESP_PANEL_BOARD_LCD_MIPI_DPI_HFP                (160)
    #define ESP_PANEL_BOARD_LCD_MIPI_DPI_VPW                (1)
    #define ESP_PANEL_BOARD_LCD_MIPI_DPI_VBP                (23)
    #define ESP_PANEL_BOARD_LCD_MIPI_DPI_VFP                (12)
    /* For DSI power PHY */
    #define ESP_PANEL_BOARD_LCD_MIPI_PHY_LDO_ID             (3)     // -1 if not used.

#else

    #error "The function is not ready and will be implemented in the future."

#endif // ESP_PANEL_BOARD_LCD_BUS_TYPE

/**
 * @brief LCD specific flags configuration
 *
 * These flags are specific to the "3-wire SPI + RGB" bus.
 */
#if (ESP_PANEL_BOARD_LCD_BUS_TYPE == ESP_PANEL_BUS_TYPE_RGB) && ESP_PANEL_BOARD_LCD_RGB_USE_CONTROL_PANEL
/**
 * @brief Enable IO multiplex
 *
 * Set to 1 if the 3-wire SPI pins are sharing other pins of the RGB interface to save GPIOs. Then, the control panel
 * and its pins (except CS signal) will be released after LCD call `init()`. All `*_by_cmd` flags will be invalid.
 */
#define ESP_PANEL_BOARD_LCD_FLAGS_ENABLE_IO_MULTIPLEX       (0) // typically set to 0
/**
 * @brief Mirror by command
 *
 * Set to 1 if the `mirror()` function will be implemented by LCD command. Otherwise, the function will be implemented by
 * software. Only valid when `ESP_PANEL_BOARD_LCD_FLAGS_ENABLE_IO_MULTIPLEX` is 0.
 */
#define ESP_PANEL_BOARD_LCD_FLAGS_MIRROR_BY_CMD             (!ESP_PANEL_BOARD_LCD_FLAGS_ENABLE_IO_MULTIPLEX)
#endif // ESP_PANEL_BOARD_LCD_RGB_USE_CONTROL_PANEL

/**
 * @brief LCD vendor initialization commands
 *
 * Vendor specific initialization can be different between manufacturers, should consult the LCD supplier for
 * initialization sequence code. Please uncomment and change the following macro definitions. Otherwise, the LCD driver
 * will use the default initialization sequence code.
 *
 * The initialization sequence can be specified in two formats:
 * 1. Raw format:
 *    {command, (uint8_t []){data0, data1, ...}, data_size, delay_ms}
 * 2. Helper macros:
 *    - ESP_PANEL_LCD_CMD_WITH_8BIT_PARAM(delay_ms, command, {data0, data1, ...})
 *    - ESP_PANEL_LCD_CMD_WITH_NONE_PARAM(delay_ms, command)
 */
/*
#define ESP_PANEL_BOARD_LCD_VENDOR_INIT_CMD()                       \
    {                                                               \
        {0xFF, (uint8_t []){0x77, 0x01, 0x00, 0x00, 0x10}, 5, 0},   \
        {0xC0, (uint8_t []){0x3B, 0x00}, 2, 0},                     \
        {0xC1, (uint8_t []){0x0D, 0x02}, 2, 0},                     \
        {0x29, (uint8_t []){0x00}, 0, 120},                         \
        or
        ESP_PANEL_LCD_CMD_WITH_8BIT_PARAM(0, 0xFF, {0x77, 0x01, 0x00, 0x00, 0x10}), \
        ESP_PANEL_LCD_CMD_WITH_8BIT_PARAM(0, 0xC0, {0x3B, 0x00}),                   \
        ESP_PANEL_LCD_CMD_WITH_8BIT_PARAM(0, 0xC1, {0x0D, 0x02}),                   \
        ESP_PANEL_LCD_CMD_WITH_NONE_PARAM(120, 0x29),                               \
    }
*/

/**
 * @brief LCD color configuration
 */
#define ESP_PANEL_BOARD_LCD_COLOR_BITS          (ESP_PANEL_LCD_COLOR_BITS_RGB565)
                                                        // ESP_PANEL_LCD_COLOR_BITS_RGB565/RGB666/RGB888
#define ESP_PANEL_BOARD_LCD_COLOR_BGR_ORDER     (0)     // 0: RGB, 1: BGR
#define ESP_PANEL_BOARD_LCD_COLOR_INEVRT_BIT    (0)     // 0/1

/**
 * @brief LCD transformation configuration
 */
#define ESP_PANEL_BOARD_LCD_SWAP_XY             (0)     // 0/1
#define ESP_PANEL_BOARD_LCD_MIRROR_X            (0)     // 0/1
#define ESP_PANEL_BOARD_LCD_MIRROR_Y            (0)     // 0/1
#define ESP_PANEL_BOARD_LCD_GAP_X               (0)     // [0, ESP_PANEL_BOARD_WIDTH]
#define ESP_PANEL_BOARD_LCD_GAP_Y               (0)     // [0, ESP_PANEL_BOARD_HEIGHT]

/**
 * @brief LCD reset pin configuration
 */
#define ESP_PANEL_BOARD_LCD_RST_IO              (-1)    // Reset pin, -1 if not used
#define ESP_PANEL_BOARD_LCD_RST_LEVEL           (0)     // Reset active level, 0: low, 1: high

#endif // ESP_PANEL_BOARD_USE_LCD

////////////////////////////////////////////////////////////////////////////////////////////////////////////////////////
//////////////////////////// Please update the following macros to configure the touch panel ///////////////////////////
////////////////////////////////////////////////////////////////////////////////////////////////////////////////////////
/**
 * @brief Touch panel configuration flag (0/1)
 *
 * Set to `1` to enable touch panel support, `0` to disable
 */
#define ESP_PANEL_BOARD_USE_TOUCH               (1)

#if ESP_PANEL_BOARD_USE_TOUCH
/**
 * @brief Touch controller selection
 *
 * Supported controllers:
 * - `AXS15231B`
 * - `CHSC6540`
 * - `CST816S`
 * - `CST820`
 * - `FT5x06`
 * - `GT911`, `GT1151`
 * - `SPD2010`
 * - `ST1633`, `ST7123`
 * - `STMPE610`
 * - `TT21100`
 * - `XPT2046`
 */
#define ESP_PANEL_BOARD_TOUCH_CONTROLLER        GT911

/**
 * @brief Touch bus type selection
 *
 * Supported types:
 * - `ESP_PANEL_BUS_TYPE_I2C`
 * - `ESP_PANEL_BUS_TYPE_SPI`
 */
#define ESP_PANEL_BOARD_TOUCH_BUS_TYPE          (ESP_PANEL_BUS_TYPE_I2C)

#if (ESP_PANEL_BOARD_TOUCH_BUS_TYPE == ESP_PANEL_BUS_TYPE_I2C) || \
    (ESP_PANEL_BOARD_TOUCH_BUS_TYPE == ESP_PANEL_BUS_TYPE_SPI)
/**
 * If set to 1, the bus will skip to initialize the corresponding host. Users need to initialize the host in advance.
 *
 * For drivers which created by this library, even if they use the same host, the host will be initialized only once.
 * So it is not necessary to set the macro to `1`. For other drivers (like `Wire`), please set the macro to `1`
 * ensure that the host is initialized only once.
 */
#define ESP_PANEL_BOARD_TOUCH_BUS_SKIP_INIT_HOST        (0)     // 0/1. Typically set to 0
#endif

/**
 * @brief Touch bus parameters configuration
 */
#if ESP_PANEL_BOARD_TOUCH_BUS_TYPE == ESP_PANEL_BUS_TYPE_I2C

    /**
     * @brief I2C bus
     */
    /* For general */
    #define ESP_PANEL_BOARD_TOUCH_I2C_HOST_ID           (0)     // Typically set to 0
#if !ESP_PANEL_BOARD_TOUCH_BUS_SKIP_INIT_HOST
    /* For host */
    #define ESP_PANEL_BOARD_TOUCH_I2C_CLK_HZ            (400 * 1000)
                                                                // Typically set to 400K
    #define ESP_PANEL_BOARD_TOUCH_I2C_SCL_PULLUP        (1)     // 0/1. Typically set to 1
    #define ESP_PANEL_BOARD_TOUCH_I2C_SDA_PULLUP        (1)     // 0/1. Typically set to 1
    #define ESP_PANEL_BOARD_TOUCH_I2C_IO_SCL            (20)
    #define ESP_PANEL_BOARD_TOUCH_I2C_IO_SDA            (19)
#endif
    /* For panel */
    #define ESP_PANEL_BOARD_TOUCH_I2C_ADDRESS           (0)     // Typically set to 0 to use the default address.
                                                                // - For touchs with only one address, set to 0
                                                                // - For touchs with multiple addresses, set to 0 or
                                                                //   the address. Like GT911, there are two addresses:
                                                                //   0x5D(default) and 0x14

#elif ESP_PANEL_BOARD_TOUCH_BUS_TYPE == ESP_PANEL_BUS_TYPE_SPI

    /**
     * @brief SPI bus
     */
    /* For general */
    #define ESP_PANEL_BOARD_TOUCH_SPI_HOST_ID           (1)     // Typically set to 1
#if !ESP_PANEL_BOARD_TOUCH_BUS_SKIP_INIT_HOST
    /* For host */
    #define ESP_PANEL_BOARD_TOUCH_SPI_IO_SCK            (7)
    #define ESP_PANEL_BOARD_TOUCH_SPI_IO_MOSI           (6)
    #define ESP_PANEL_BOARD_TOUCH_SPI_IO_MISO           (9)
#endif
    /* For panel */
    #define ESP_PANEL_BOARD_TOUCH_SPI_IO_CS             (5)
    #define ESP_PANEL_BOARD_TOUCH_SPI_CLK_HZ            (1 * 1000 * 1000)  // Should be integer divisor of 80M

#else

    #error "The function is not ready and will be implemented in the future."

#endif // ESP_PANEL_BOARD_TOUCH_BUS_TYPE

/**
 * @brief Touch panel transformation flags
 */
#define ESP_PANEL_BOARD_TOUCH_SWAP_XY           (0)     // 0/1
#define ESP_PANEL_BOARD_TOUCH_MIRROR_X          (0)     // 0/1
#define ESP_PANEL_BOARD_TOUCH_MIRROR_Y          (0)     // 0/1

/**
 * @brief Touch panel control pins
 */
#define ESP_PANEL_BOARD_TOUCH_RST_IO            (38)    // Reset pin, -1 if not used
#define ESP_PANEL_BOARD_TOUCH_RST_LEVEL         (0)     // Reset active level, 0: low, 1: high
#define ESP_PANEL_BOARD_TOUCH_INT_IO            (-1)    // Interrupt pin, -1 if not used
#define ESP_PANEL_BOARD_TOUCH_INT_LEVEL         (0)     // Interrupt active level, 0: low, 1: high

#endif // ESP_PANEL_BOARD_USE_TOUCH

////////////////////////////////////////////////////////////////////////////////////////////////////////////////////////
///////////////////////////// Please update the following macros to configure the backlight ////////////////////////////
////////////////////////////////////////////////////////////////////////////////////////////////////////////////////////
/**
 * @brief Backlight configuration flag (0/1)
 *
 * Set to `1` to enable backlight support, `0` to disable
 */
#define ESP_PANEL_BOARD_USE_BACKLIGHT           (1)

#if ESP_PANEL_BOARD_USE_BACKLIGHT
/**
 * @brief Backlight control type selection
 *
 * Supported types:
 * - `ESP_PANEL_BACKLIGHT_TYPE_SWITCH_GPIO`: Use GPIO switch to control the backlight, only support on/off
 * - `ESP_PANEL_BACKLIGHT_TYPE_SWITCH_EXPANDER`: Use IO expander to control the backlight, only support on/off
 * - `ESP_PANEL_BACKLIGHT_TYPE_PWM_LEDC`: Use LEDC PWM to control the backlight, support brightness adjustment
 * - `ESP_PANEL_BACKLIGHT_TYPE_CUSTOM`: Use custom function to control the backlight
 */
#define ESP_PANEL_BOARD_BACKLIGHT_TYPE          (ESP_PANEL_BACKLIGHT_TYPE_PWM_LEDC)

#if (ESP_PANEL_BOARD_BACKLIGHT_TYPE == ESP_PANEL_BACKLIGHT_TYPE_SWITCH_GPIO) || \
    (ESP_PANEL_BOARD_BACKLIGHT_TYPE == ESP_PANEL_BACKLIGHT_TYPE_SWITCH_EXPANDER) || \
    (ESP_PANEL_BOARD_BACKLIGHT_TYPE == ESP_PANEL_BACKLIGHT_TYPE_PWM_LEDC)

    /**
     * @brief Backlight control pin configuration
     */
    #define ESP_PANEL_BOARD_BACKLIGHT_IO        (2)    // Output GPIO pin number
    #define ESP_PANEL_BOARD_BACKLIGHT_ON_LEVEL  (1)     // Active level, 0: low, 1: high

#if ESP_PANEL_BOARD_BACKLIGHT_TYPE == ESP_PANEL_BACKLIGHT_TYPE_PWM_LEDC
    /**
     * @brief PWM parameters configuration
     */
    #define ESP_PANEL_BOARD_BACKLIGHT_PWM_FREQ_HZ   (5000)  // LEDC timer frequency.
                                                            // Different backlight driver chips may have different
                                                            // frequency limits, please refer to the datasheet of
                                                            // the specific chip.
                                                            // https://github.com/esp-arduino-libs/ESP32_Display_Panel/issues/188

    #define ESP_PANEL_BOARD_BACKLIGHT_PWM_DUTY_RESOLUTION  (10) // LEDC timer duty resolution.
                                                                // The frequency and duty resolution of the LEDC timer
                                                                // need to be properly matched, please refer to:
                                                                // https://docs.espressif.com/projects/esp-idf/en/latest/esp32/api-reference/peripherals/ledc.html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
#endif

#elif ESP_PANEL_BOARD_BACKLIGHT_TYPE == ESP_PANEL_BACKLIGHT_TYPE_CUSTOM

    /**
     * @brief Custom backlight control function
     *
     * @param[in] percent    Brightness percentage (0-100)
     * @param[in] user_data  User data pointer, typically points to Board instance.
     *
     * @return true on success, false on failure
     */
    #define ESP_PANEL_BOARD_BACKLIGHT_CUSTOM_FUNCTION(percent, user_data)  \
        {  \
            auto board = static_cast<Board *>(user_data);  \
            return true; \
        }

#endif // ESP_PANEL_BOARD_BACKLIGHT_TYPE

/**
 * @brief Backlight idle state configuration (0/1)
 *
 * Set to 1 if want to turn off the backlight after initializing. Otherwise, the backlight will be on.
 */
#define ESP_PANEL_BOARD_BACKLIGHT_IDLE_OFF      (0)

#endif // ESP_PANEL_BOARD_USE_BACKLIGHT

////////////////////////////////////////////////////////////////////////////////////////////////////////////////////////
///////////////////////////// Please update the following macros to configure the IO expander //////////////////////////
////////////////////////////////////////////////////////////////////////////////////////////////////////////////////////
/**
 * @brief IO expander configuration flag (0/1)
 *
 * Set to `1` to enable IO expander support, `0` to disable
 */
#define ESP_PANEL_BOARD_USE_EXPANDER            (0)

#if ESP_PANEL_BOARD_USE_EXPANDER
/**
 * @brief IO expander chip selection
 *
 * Supported chips:
 * - `CH422G`
 * - `HT8574`
 * - `TCA95XX_8BIT`
 * - `TCA95XX_16BIT`
 */
#define ESP_PANEL_BOARD_EXPANDER_CHIP           TCA95XX_8BIT

/**
 * @brief IO expander I2C bus parameters configuration
 */
/**
 * If set to 1, the bus will skip to initialize the corresponding host. Users need to initialize the host in advance.
 *
 * For drivers which created by this library, even if they use the same host, the host will be initialized only once.
 * So it is not necessary to set the macro to `1`. For other devices, please set the macro to `1` ensure that the
 * host is initialized only once.
 */
#define ESP_PANEL_BOARD_EXPANDER_SKIP_INIT_HOST     (0)     // 0/1
/* For general */
#define ESP_PANEL_BOARD_EXPANDER_I2C_HOST_ID        (0)     // Typically set to 0
/* For host */
#if !ESP_PANEL_BOARD_EXPANDER_SKIP_INIT_HOST
#define ESP_PANEL_BOARD_EXPANDER_I2C_CLK_HZ         (400 * 1000)
                                                            // Typically set to 400K
#define ESP_PANEL_BOARD_EXPANDER_I2C_SCL_PULLUP     (1)     // 0/1. Typically set to 1
#define ESP_PANEL_BOARD_EXPANDER_I2C_SDA_PULLUP     (1)     // 0/1. Typically set to 1
#define ESP_PANEL_BOARD_EXPANDER_I2C_IO_SCL         (18)
#define ESP_PANEL_BOARD_EXPANDER_I2C_IO_SDA         (8)
#endif // ESP_PANEL_BOARD_EXPANDER_SKIP_INIT_HOST
/* For device */
#define ESP_PANEL_BOARD_EXPANDER_I2C_ADDRESS        (0x20)  // The actual I2C address. Even for the same model of IC,
                                                            // the I2C address may be different, and confirmation based on
                                                            // the actual hardware connection is required
#endif // ESP_PANEL_BOARD_USE_EXPANDER

////////////////////////////////////////////////////////////////////////////////////////////////////////////////////////
/////////////////////// Please utilize the following macros to execute any additional code if required /////////////////
////////////////////////////////////////////////////////////////////////////////////////////////////////////////////////
/**
 * @brief Pre-begin function for board initialization
 *
 * @param[in] p Pointer to the board object
 * @return true on success, false on failure
 */
/*
#define ESP_PANEL_BOARD_PRE_BEGIN_FUNCTION(p) \
    {  \
        auto board = static_cast<Board *>(p);  \
        return true;    \
    }
*/

/**
 * @brief Post-begin function for board initialization
 *
 * @param[in] p Pointer to the board object
 * @return true on success, false on failure
 */
/*
#define ESP_PANEL_BOARD_POST_BEGIN_FUNCTION(p) \
    {  \
        auto board = static_cast<Board *>(p);  \
        return true;    \
    }
*/

/**
 * @brief Pre-delete function for board initialization
 *
 * @param[in] p Pointer to the board object
 * @return true on success, false on failure
 */
/*
#define ESP_PANEL_BOARD_PRE_DEL_FUNCTION(p) \
    {  \
        auto board = static_cast<Board *>(p);  \
        return true;    \
    }
*/

/**
 * @brief Post-delete function for board initialization
 *
 * @param[in] p Pointer to the board object
 * @return true on success, false on failure
 */
/*
#define ESP_PANEL_BOARD_POST_DEL_FUNCTION(p) \
    {  \
        auto board = static_cast<Board *>(p);  \
        return true;    \
    }
*/

/**
 * @brief Pre-begin function for IO expander initialization
 *
 * @param[in] p Pointer to the board object
 * @return true on success, false on failure
 */
/*
#define ESP_PANEL_BOARD_EXPANDER_PRE_BEGIN_FUNCTION(p) \
    {  \
        auto board = static_cast<Board *>(p);  \
        return true;    \
    }
*/

/**
 * @brief Post-begin function for IO expander initialization
 *
 * @param[in] p Pointer to the board object
 * @return true on success, false on failure
 */
/*
#define ESP_PANEL_BOARD_EXPANDER_POST_BEGIN_FUNCTION(p) \
    {  \
        auto board = static_cast<Board *>(p);  \
        return true;    \
    }
*/

/**
 * @brief Pre-begin function for LCD initialization
 *
 * @param[in] p Pointer to the board object
 * @return true on success, false on failure
 */
/*
#define ESP_PANEL_BOARD_LCD_PRE_BEGIN_FUNCTION(p) \
    {  \
        auto board = static_cast<Board *>(p);  \
        return true;    \
    }
*/

/**
 * @brief Post-begin function for LCD initialization
 *
 * @param[in] p Pointer to the board object
 * @return true on success, false on failure
 */
/*
#define ESP_PANEL_BOARD_LCD_POST_BEGIN_FUNCTION(p) \
    {  \
        auto board = static_cast<Board *>(p);  \
        return true;    \
    }
*/

/**
 * @brief Pre-begin function for touch panel initialization
 *
 * @param[in] p Pointer to the board object
 * @return true on success, false on failure
 */
/*
#define ESP_PANEL_BOARD_TOUCH_PRE_BEGIN_FUNCTION(p) \
    {  \
        auto board = static_cast<Board *>(p);  \
        return true;    \
    }
*/

/**
 * @brief Post-begin function for touch panel initialization
 *
 * @param[in] p Pointer to the board object
 * @return true on success, false on failure
 */
/*
#define ESP_PANEL_BOARD_TOUCH_POST_BEGIN_FUNCTION(p) \
    {  \
        auto board = static_cast<Board *>(p);  \
        return true;    \
    }
*/

/**
 * @brief Pre-begin function for backlight initialization
 *
 * @param[in] p Pointer to the board object
 * @return true on success, false on failure
 */
/*
#define ESP_PANEL_BOARD_BACKLIGHT_PRE_BEGIN_FUNCTION(p) \
    {  \
        auto board = static_cast<Board *>(p);  \
        return true;    \
    }
*/

/**
 * @brief Post-begin function for backlight initialization
 *
 * @param[in] p Pointer to the board object
 * @return true on success, false on failure
 */
/*
#define ESP_PANEL_BOARD_BACKLIGHT_POST_BEGIN_FUNCTION(p) \
    {  \
        auto board = static_cast<Board *>(p);  \
        return true;    \
    }
*/

////////////////////////////////////////////////////////////////////////////////////////////////////////////////////////
/////////////////////////////////////////////// File Version ///////////////////////////////////////////////////////////
////////////////////////////////////////////////////////////////////////////////////////////////////////////////////////
/**
 * Do not change the following versions. These version numbers are used to check compatibility between this
 * configuration file and the library. Rules for version numbers:
 * 1. Major version mismatch: Configurations are incompatible, must use library version
 * 2. Minor version mismatch: May be missing new configurations, recommended to update
 * 3. Patch version mismatch: No impact on functionality
 */
#define ESP_PANEL_BOARD_CUSTOM_FILE_VERSION_MAJOR 1
#define ESP_PANEL_BOARD_CUSTOM_FILE_VERSION_MINOR 2
#define ESP_PANEL_BOARD_CUSTOM_FILE_VERSION_PATCH 0

#endif // ESP_PANEL_BOARD_DEFAULT_USE_CUSTOM

// *INDENT-ON*
