sachinthaLUT/RIGOR/firmware/hmi/TouchScreenESP32Firmware/esp_utils_conf.h

/*
 * SPDX-FileCopyrightText: 2024-2025 Espressif Systems (Shanghai) CO LTD
 *
 * SPDX-License-Identifier: Apache-2.0
 */

#pragma once

// *INDENT-OFF*

////////////////////////////////////////////////////////////////////////////////////////////////////////////////////////
///////////////////////////////////////////////// Check Configurations /////////////////////////////////////////////////
////////////////////////////////////////////////////////////////////////////////////////////////////////////////////////
/**
 * Check handle method, choose one of the following:
 *  - ESP_UTILS_CHECK_HANDLE_WITH_NONE:      Do nothing when check failed (Minimum code size)
 *  - ESP_UTILS_CHECK_HANDLE_WITH_ERROR_LOG: Print error message when check failed (Recommended)
 *  - ESP_UTILS_CHECK_HANDLE_WITH_ASSERT:    Assert when check failed
 */
#define ESP_UTILS_CONF_CHECK_HANDLE_METHOD                  (ESP_UTILS_CHECK_HANDLE_WITH_ERROR_LOG)

////////////////////////////////////////////////////////////////////////////////////////////////////////////////////////
////////////////////////////////////////////////// Log Configurations //////////////////////////////////////////////////
////////////////////////////////////////////////////////////////////////////////////////////////////////////////////////
/**
 * Global log level, logs with a level lower than this will not be compiled. Choose one of the following:
 *  - ESP_UTILS_LOG_LEVEL_DEBUG:   Extra information which is not necessary for normal use (values, pointers, sizes, etc)
 *                                 (lowest level)
 *  - ESP_UTILS_LOG_LEVEL_INFO:    Information messages which describe the normal flow of events
 *  - ESP_UTILS_LOG_LEVEL_WARNING: Error conditions from which recovery measures have been taken
 *  - ESP_UTILS_LOG_LEVEL_ERROR:   Critical errors, software module cannot recover on its own
 *  - ESP_UTILS_LOG_LEVEL_NONE:    No log output (highest level) (Minimum code size)
 */
// CHANGED: INFO -> NONE.
//
// This library logs to UART0, which on this board is GPIO43/44 -- the same
// pins carrying the link to the rig. At INFO level the "[I][Panel]..." init
// messages land in the rig's receiver as garbage commands. NONE removes them
// at compile time (Tools > Core Debug Level does NOT affect this library).
//
// Set back to INFO temporarily if you need to debug panel bring-up, but
// unplug the rig link first.
#define ESP_UTILS_CONF_LOG_LEVEL                            (ESP_UTILS_LOG_LEVEL_NONE)
#if ESP_UTILS_CONF_LOG_LEVEL == ESP_UTILS_LOG_LEVEL_DEBUG

    /**
     * @brief Set to 1 if print trace log messages when enter/exit functions, useful for debugging
     */
    #define ESP_UTILS_CONF_ENABLE_LOG_TRACE                 (0)

#endif // ESP_UTILS_CONF_LOG_LEVEL

////////////////////////////////////////////////////////////////////////////////////////////////////////////////////////
//////////////////////////////////////////////// Memory Configurations /////////////////////////////////////////////////
////////////////////////////////////////////////////////////////////////////////////////////////////////////////////////
/**
 * Default enable memory allocation.
 *
 * If enabled, the driver will use general memory allocation by default, otherwise, the driver will use `malloc` and
 * `free` by default
 */
#define ESP_UTILS_CONF_MEM_GEN_ALLOC_DEFAULT_ENABLE         (1)

/**
 * General Memory allocation type, choose one of the following:
 *  - ESP_UTILS_MEM_ALLOC_TYPE_STDLIB:      Use the standard library memory allocation functions (malloc, free)
 *  - ESP_UTILS_MEM_ALLOC_TYPE_ESP:         Use the ESP-IDF memory allocation functions (heap_caps_aligned_alloc, heap_caps_free)
 *  - ESP_UTILS_MEM_ALLOC_TYPE_MICROPYTHON: Use the MicroPython memory allocation functions (m_malloc, m_free)
 *  - ESP_UTILS_MEM_ALLOC_TYPE_CUSTOM:      Use custom memory allocation functions (ESP_UTILS_MEM_ALLOC_CUSTOM_MALLOC,
 *                                          ESP_UTILS_MEM_ALLOC_CUSTOM_FREE)
 */
#define ESP_UTILS_CONF_MEM_GEN_ALLOC_TYPE                   (ESP_UTILS_MEM_ALLOC_TYPE_STDLIB)
#if ESP_UTILS_CONF_MEM_GEN_ALLOC_TYPE == ESP_UTILS_MEM_ALLOC_TYPE_ESP

    #define ESP_UTILS_CONF_MEM_GEN_ALLOC_ESP_ALIGN          (1)
    #define ESP_UTILS_CONF_MEM_GEN_ALLOC_ESP_CAPS           (MALLOC_CAP_DEFAULT | MALLOC_CAP_8BIT)

#elif ESP_UTILS_CONF_MEM_GEN_ALLOC_TYPE == ESP_UTILS_MEM_ALLOC_TYPE_CUSTOM

    #define ESP_UTILS_CONF_MEM_GEN_ALLOC_CUSTOM_INCLUDE     "stdlib.h"
    #define ESP_UTILS_CONF_MEM_GEN_ALLOC_CUSTOM_MALLOC      malloc
    #define ESP_UTILS_CONF_MEM_GEN_ALLOC_CUSTOM_FREE        free

#endif // ESP_UTILS_CONF_MEM_GEN_ALLOC_TYPE
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
