sachinthaLUT/RIGOR/(commit log)

2026-11-10 Original Repository for RIGOR
    Original files for the RIGOR repository
    [Actuator bracket 1.SLDDRW, Actuator bracket 2.SLDDRW, Assembly.SLDASM, BracketLid.SLDDRW, E-STOP AB6E-3BV02PTRM.stp, Enclosure Body.3MF, Enclosure Lid.3MF, Enclosure.SLDPRT]
2026-11-13 Corrections to first repo
    Corrections to first repo
    [Actuator bracket 1.SLDDRW, Actuator bracket 2.SLDDRW, BOM.csv, BracketLid.SLDDRW, Force plate.SLDDRW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]
