sachinthaLUT/RIGOR/(notices)

Notices in the files:
README.md:
Hardware licence
